eorzes/PSLink_v1/PCB-3D.png

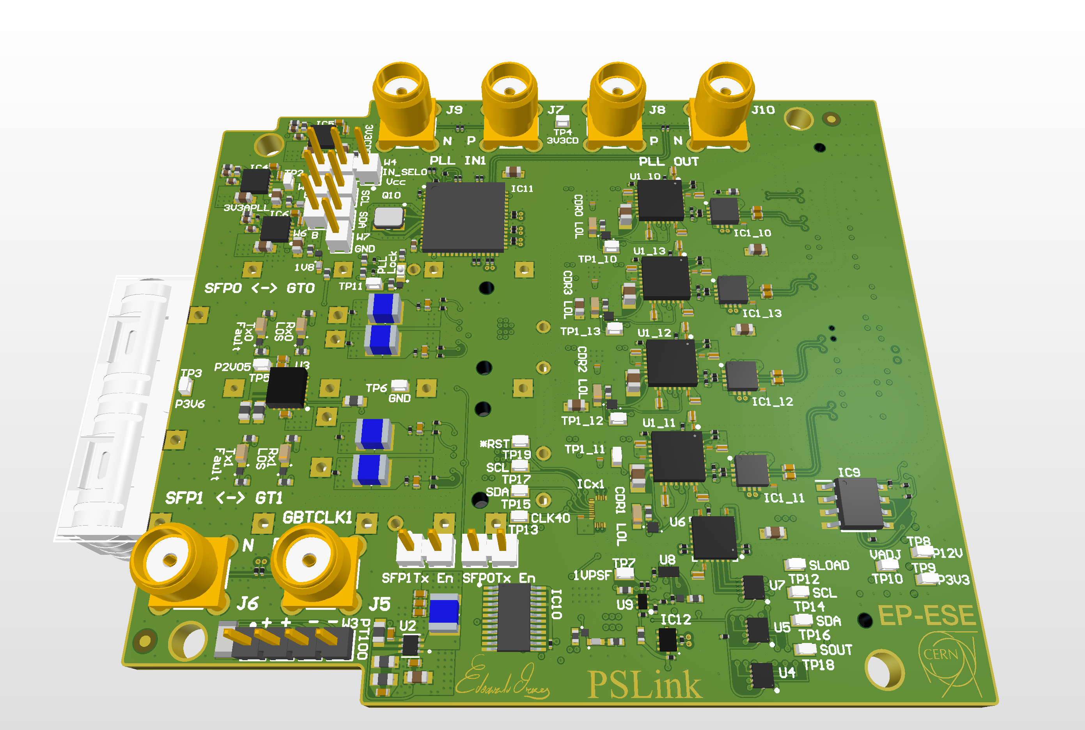
PCB-3D.png
