eorzes/PSLink_v1/PCB-3D-bot.png

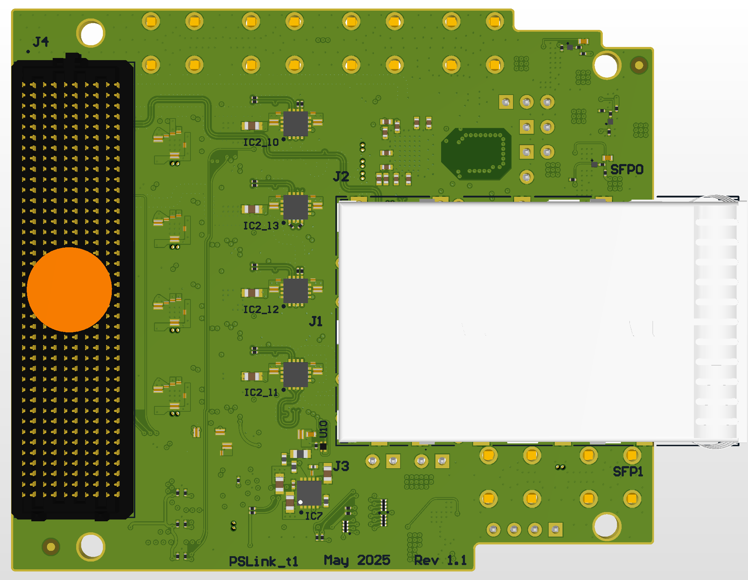
PCB-3D-bot.png
