eorzes/PSLink_v1/PCB-3D-top.png

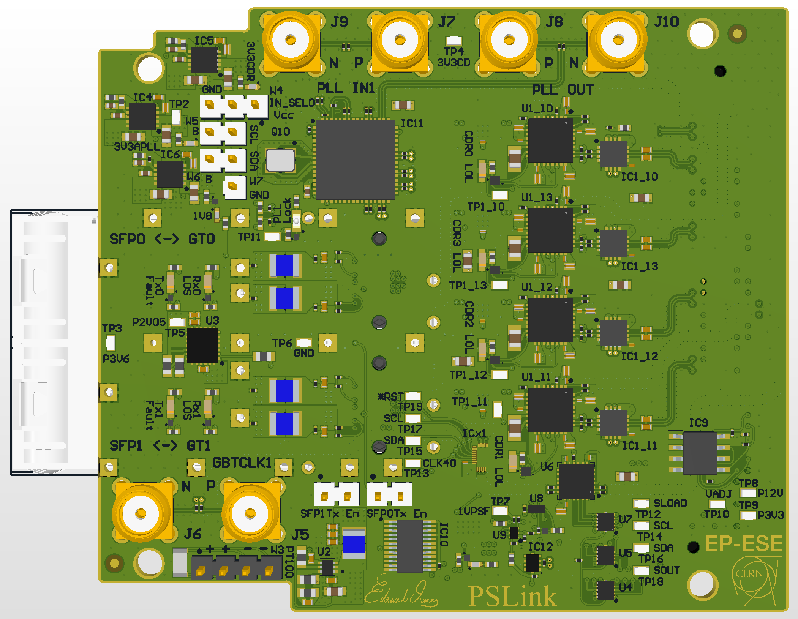
PCB-3D-top.png
