eorzes/PSLink_v1/SI_simulations/CML_Driver/AC_coupling_no50pullup.PNG

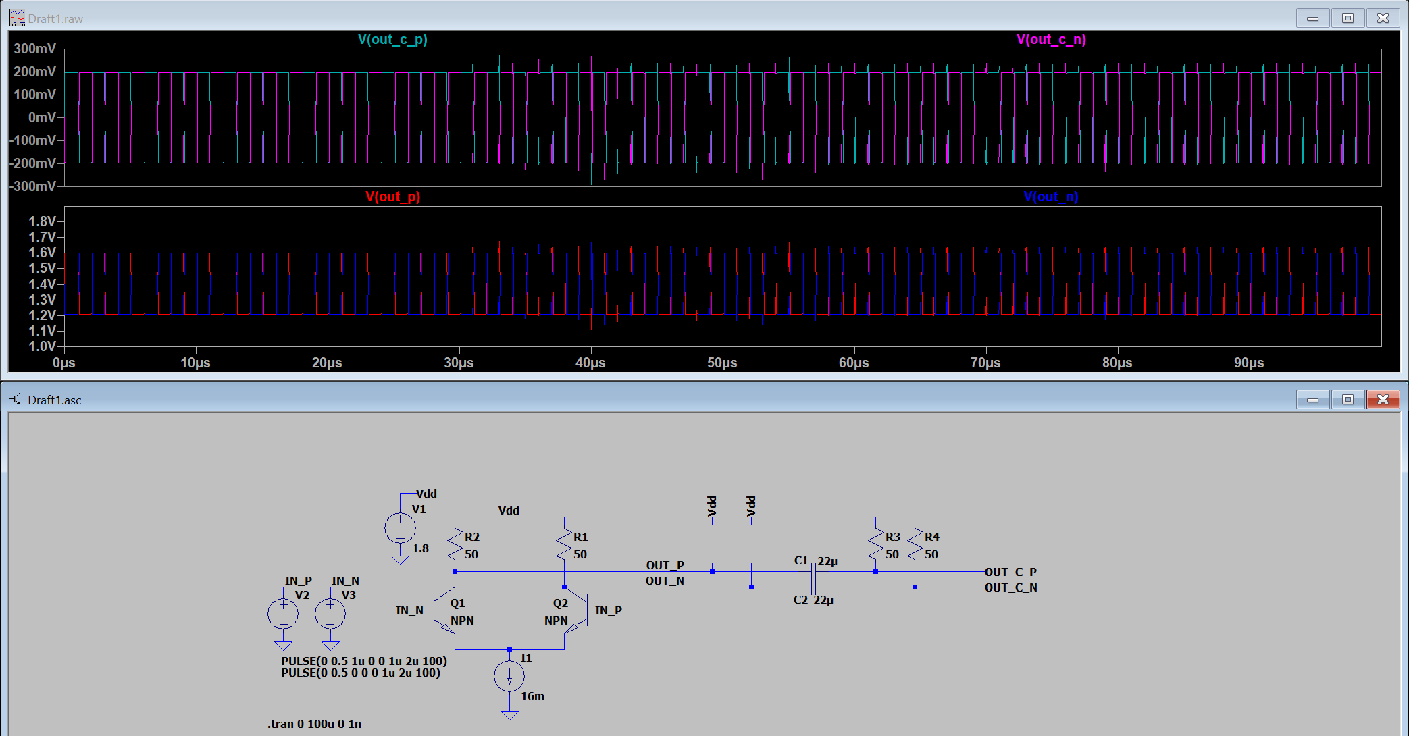
SI_simulations/CML_Driver/AC_coupling_no50pullup.PNG
