eorzes/PSLink_v1/Signature.png

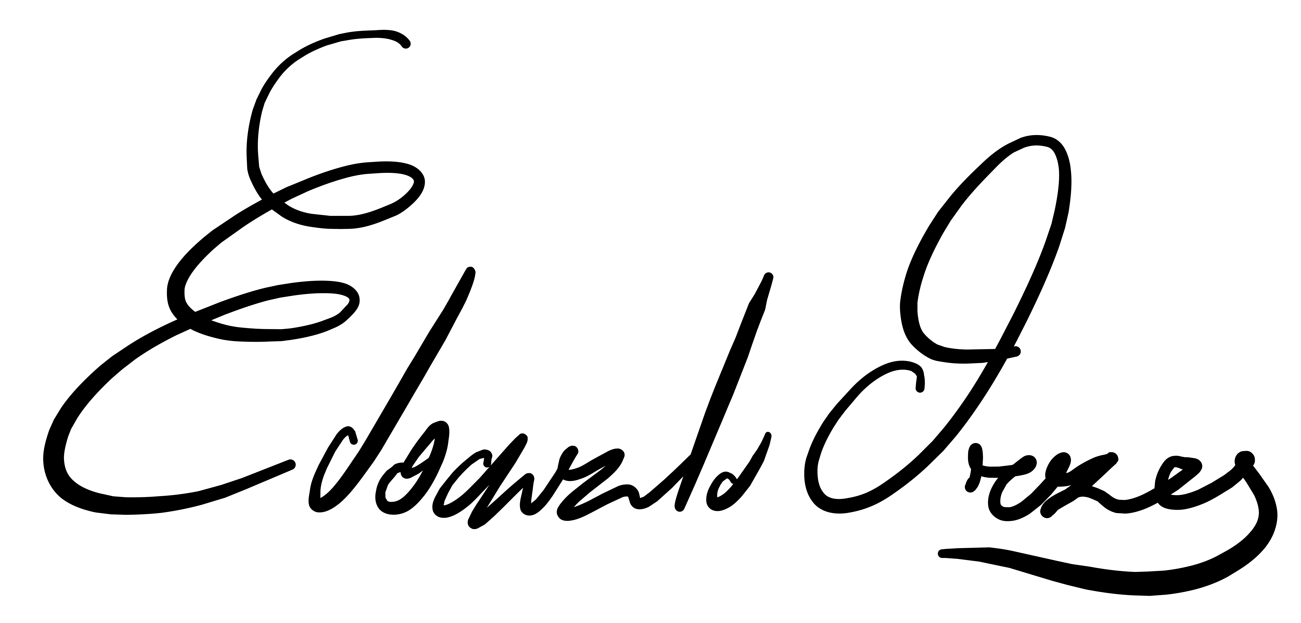
Signature.png
