eorzes/PSLink_v1/BOM_PSLink_v1.csv

Designator | Quantity | Manufacturer | Description | Comment | Footprint | Package | LibRef
C1_l0, C1_l1, C1_l2, C1_l3, C4_l0, C4_l1, C4_l2, C4_l3, C7_l0, C7_l1, C7_l2, C7_l3, C9_l0, C9_l1, C9_l2, C9_l3, C14_l0, C14_l1, C14_l2, C14_l3, C16_l0, C16_l1, C16_l2, C16_l3, C19_l0, C19_l1, C19_l2, C19_l3, C21_l0, C21_l1, C21_l2, C21_l3, C26_l0, C26_l1, C26_l2, C26_l3, C38, C51, C60, C132, C134, C136, C138, C143 | 44 |  | LLL153C70G474ME17 | 470nF | CAPC0510X04N |  | Capacitor - non polarized
C2_l0, C2_l1, C2_l2, C2_l3, C5_l0, C5_l1, C5_l2, C5_l3, C8_l0, C8_l1, C8_l2, C8_l3, C10_l0, C10_l1, C10_l2, C10_l3, C11_l0, C11_l1, C11_l2, C11_l3, C15_l0, C15_l1, C15_l2, C15_l3, C17_l0, C17_l1, C17_l2, C17_l3, C20_l0, C20_l1, C20_l2, C20_l3, C22_l0, C22_l1, C22_l2, C22_l3, C23_l0, C23_l1, C23_l2, C23_l3, C25_l0, C25_l1, C25_l2, C25_l3, C27_l0, C27_l1, C27_l2, C27_l3, C31_l0, C31_l1, C31_l2, C31_l3, C66, C133, C135, C137, C139, C144 | 58 |  | LLL03TR61E333KE01 | 33nF | LLL03TR61E333KE01 |  | Capacitor - non polarized
C3_l0, C3_l1, C3_l2, C3_l3, C6_l0, C6_l1, C6_l2, C6_l3, C34, C35, C43, C46, C47, C56, C57, C62, C65, C67, C129, C130 | 20 | GENERIC | C1608X5R1E106M080AC | 10uF | CAPC1608X87N |  | CC0603_10UF_6.3V_20%_X5R
C12_l0, C12_l1, C12_l2, C12_l3, C24_l0, C24_l1, C24_l2, C24_l3, C37, C44, C45, C50, C53, C54, C55, C59, C70, C73, C76, C79, C131 | 21 |  | GRM155R60J226ME11 | 22uF | MURATA_HI_DENSITY_0402_CAP |  | C0402-22uF-high-density
C13_l0, C13_l1, C13_l2, C13_l3, C18_l0, C18_l1, C18_l2, C18_l3, C28_l0, C28_l1, C28_l2, C28_l3, C29_l0, C29_l1, C29_l2, C29_l3, C30_l0, C30_l1, C30_l2, C30_l3, C33, C69, C71, C72, C74, C75, C77, C78, C80, C81, C82, C83, C84, C85, C86, C87, C88, C89, C90, C91, C92, C93, C94, C95, C96, C97, C98, C99, C100, C101, C102, C103, C104, C105, C106, C107, C108, C109, C110, C111, C112, C113, C114, C119, C120, C140, C141, C142, C145, C146, C147, C148, C149, C150, C151 | 75 |  | GRM033R61C104KE14 | 100nF | MURATA_HI_DENSITY_0201 |  | C0201-100nF-high-density
C32_l0, C32_l1, C32_l2, C32_l3 | 4 | MURATA | GCM21BR71H474KA55L | 470nF | CAPC2013X140N |  | CC0805_470NF_50V_10%_X7R_MURATA_GCM21BR71H474KA55L
C36, C39, C49, C52, C58, C61, C115, C116, C117, C118, C121, C122, C123, C124, C125, C126, C127, C128 | 18 | GENERIC | GRM153B30J105ME15 | 1uF | CAPC1005X55N |  | CC0402_1UF_16V_10%_X5R
C40, C41, C42 | 3 |  | GRM155R71E104KE14 | 100nF | MURATA_HI_DENSITY_0402_CAP |  | C0402-22uF-high-density
C48, C63, C68 | 3 |  | C0402C220J4GACTU | 22pF | MURATA_HI_DENSITY_0402_CAP |  | C0402-22uF-high-density
C64 | 1 | TDK | GRM033C80J224KE90D | 220nF | CAPC0603X33N |  | CC0201_220NF_6.3V_10%_X7S_TDK_C0603X7S0J224K030
D1, D2, D3, D4 | 4 |  | Led Green 0402 2mA 2.65V 40mcd 102mW | APHHS1005LZGCK-V | LED_APHHS1005LZGCK-V | 0402 Kingbright Corporation | APHHS1005LZGCK-V
D5 | 1 |  | LED | APTD1608LVBC_D | LEDC1608X110N |  | APTD1608LVBC_D
FTG1, FTG2, FTG3, FTG4 | 4 |  | Fiducial Target | Use only in PCB | FIDUCIAL_TOP_C100-200 |  | FIDUCIAL_TARGET_C100-200
IC1_l0, IC1_l1, IC1_l2, IC1_l3 | 4 |  | Integrated Circuit | NB7V52MMNG | QFN50P300X300X100-17N |  | NB7V52MMNG
IC2_l0, IC2_l1, IC2_l2, IC2_l3 | 4 |  | Integrated Circuit | NB7VQ14MMNHTBG | QFN50P300X300X100-17N |  | NB7VQ14MMNHTBG
IC3_l0, IC3_l1, IC3_l2, IC3_l3 | 4 |  | Integrated Circuit | 74AUP1G32GS,132 | 74LVC1G3157GS132 |  | 74AUP1G32GS,132
IC4, IC5, IC6 | 3 |  | Integrated Circuit | ADP7159ACPZ-04-R7 | SON50P300X300X85-11N-D |  | ADP7159ACPZ-04-R7
IC7 | 1 | LINEAR TECHNOLOGY | 20V, 500mA, Ultralow Noise, Ultrahigh PSRR Linear Regulator | LT3045EDD | SON50P300X300X80-11N-R175X248 |  | LT3045EDD#PBF
IC8 | 1 |  | 32207590 - PT100 - 1206 - 0.3degC - -50/130 | 32207590 | PT100 |  | PT100
IC9 | 1 |  | Integrated Circuit | M24C02-RMN6TP | SOIC127P600X175-8N |  | M24C02-RMN6TP
IC10 | 1 |  | Integrated Circuit | TCA9548ADGSR | SOP50P490X110-24N |  | TCA9548ADGSR
IC11 | 1 |  | Integrated Circuit | SI5345B-D-GM | QFN50P900X900X90-65N-D |  | SI5345B-D-GM
IC12 | 1 |  | Integrated Circuit | SN65LVDS4RSER | SN65LVDS4RSER |  | SN65LVDS4RSER
ICx1 | 1 |  |  | DCPS3 | DCPS3-Large |  | DCPS3
J1 | 1 |  | Connector | 2007263-1_NP | 20072631_NP |  | 2007263-1_NP
J2, J3 | 2 | TYCO ELECTRONICS | 20 Position SFP+ Connector (Small Form-factor Pluggable) | SFP+ | TYCO_1888247-1 |  | TYCO_1888247-1
J4 | 1 |  |  | SEAM-40-03.5-S-10-2-A-K-TR | SAMTEC_SEAM-40-03.5-S-10-2-A-K-TR | None | SEAM-40-03.5-S-10-2-A-K-TR
J5, J6, J7, J8, J9, J10 | 6 | SAMTEC |  | SMA | SAMTEC_SMA-J-P-H-ST-MT1 |  | SAMTEC_SMA-J-P-H-ST-MT1
L1, L2, L3, L4, L5 | 5 |  | Inductor | 4.7uH | DFE322520FD1R0MP2 |  | DFE322520FD-4R7M=P2
LED1_l0, LED1_l1, LED1_l2, LED1_l3, LED2, LED3, LED4, LED5 | 8 |  | Led Red 0603 2mA 1.8V 50mcd 84mW | APTD1608LSECKJ3-PF | LED_APTD1608LSECKJ3-PF_KNB |  | APTD1608LSECKJ3-PF
Q1, Q2, Q3, Q4, Q5, Q6, Q7, Q8, Q9, Q11, Q12 | 11 |  | MOSFET (N-Channel) | CSD15380F3 | CSD15380F3 |  | CSD15380F3
Q10 | 1 | KYOCERA | Crystal 4 pins 1=XTAL Control 2=GND3=XTAL 4=GND | 48MHz | XTAL_KYOCERA_CX3225SB |  | XTAL_48MHZ_KYOCERA_CX3225SB48000D0FPJC1
R1_l0, R1_l1, R1_l2, R1_l3, R2_l0, R2_l1, R2_l2, R2_l3, R5_l0, R5_l1, R5_l2, R5_l3, R8, R29, R37, R65, R66, R67, R75 | 19 |  | Resistor | 100O | MURATA_HI_DENSITY_0201 |  | R0201-100ohm-high-density
R3_l0, R3_l1, R3_l2, R3_l3, R4_l0, R4_l1, R4_l2, R4_l3, R23, R27, R43, R44, R45, R48, R51, R52, R53, R56, R57, R58, R59, R60, R61, R62, R63, R64, R68, R69, R76, R81, R82, R83, R84 | 33 |  | Resistor 10k | 10k | MURATA_HI_DENSITY_0201 |  | R0201-100ohm-high-density
R6_l0, R6_l1, R6_l2, R6_l3, R41, R42, R49, R50, R77 | 9 | GENERIC | Resistor - 1% | 1k5 | RESC1005X40N |  | R0402_1K5_1%_0.0625W_100PPM
R7, R10, R28, R32, R36, R40, R78, R79 | 8 |  | Resistor 1M | 1M | MURATA_HI_DENSITY_0201 |  | R0201-100ohm-high-density
R9, R14, R21, R31, R72 | 5 | GENERIC | Resistor - 1% | 750 | RESC1005X40N |  | R0402_750R_1%_0.0625W_100PPM
R11, R17 | 2 | GENERIC | Resistor - 1% | 47k | RESC1005X40N |  | R0402_47K_1%_0.0625W_100PPM
R12, R18 | 2 | GENERIC | Resistor - 1% | 27k | RESC1005X40N |  | R0402_27K_1%_0.0625W_100PPM
R13, R19, R22 | 3 | GENERIC | Resistor - 1% | 100k | RESC1608X55N |  | R0603_30K_1%_0.1W_100PPM
R15 | 1 | GENERIC | Resistor - 1% | 150k | RESC1608X55N |  | R0603_150K_1%_0.1W_100PPM
R16 | 1 | GENERIC | Resistor - 1% | 30k | RESC1608X55N |  | R0603_30K_1%_0.1W_100PPM
R20, R39 | 2 | GENERIC | Resistor - 1% | 243k | RESC1608X55N |  | R0603_30K_1%_0.1W_100PPM
R24, R33, R38, R46, R47, R54, R55, R73, R74, R80 | 10 | GENERIC | Resistor - 1% | 200k | RESC1005X40N |  | R0402_200K_1%_0.0625W_100PPM
R25 | 1 | GENERIC | Resistor - 1% | 5k1 | RESC1005X40N |  | R0402_5K1_1%_0.0625W_100PPM
R26 | 1 | GENERIC | Resistor - 1% | 20k | RESC1005X40N |  | R0402_20K_1%_0.0625W_100PPM
R30 | 1 | GENERIC | Resistor - 1% | 300 | RESC1005X40N |  | R0402_300R_1%_0.0625W_100PPM
R34 | 1 | GENERIC | Resistor - 1% | 750k | RESC1005X40N |  | R0402_750K_1%_0.0625W_100PPM
R35 | 1 | GENERIC | Resistor | 10k | RESC0603X28N |  | R0201_0R_JUMPER
R70, R71 | 2 | GENERIC | Resistor - 1% | 22 | RESC1005X40N |  | R0402_22R_1%_0.0625W_100PPM
RN1, RN2, RN3 | 3 |  | Resistor Network (8-Pin) 10k | EXB-U18103JX | EXBU18 |  | EXB-U18103JX
TP1_l0, TP1_l1, TP1_l2, TP1_l3, TP2, TP3, TP4, TP5, TP6, TP7, TP8, TP9, TP10, TP11, TP12, TP13, TP14, TP15, TP16, TP17, TP18, TP19 | 22 |  |  | RCU-0C | TP+195X110 | None | RCU-0C
U1_l0, U1_l1, U1_l2, U1_l3 | 4 |  | CDR | ADN2817ACPZ-RL7 | CP_32_11_ADI |  | ADN2817ACPZ-RL7
U2 | 1 |  | No Description Available | TPS563203DRLR | SOT_07SDRLR_TEX |  | TPS563203DRLR
U3 | 1 |  | No Description Available | TPSM82866AA0SRDJR | RDJ0023A-MFG |  | XPSM82866AA0SRDJR
U4, U5, U7 | 3 |  | No Description Available | TXB0104RUTR | RUT12_TEX |  | TXB0104RUTR
U6 | 1 |  | Coarse Phase Shifter (5ps/5ns) | SY89297UMG-TR | QFN-24_MCH-L |  | SY89297UMG-TR
U8 | 1 |  | No Description Available | SN74AUC2G241YZPR | YZP8 |  | SN74AUC2G241YZPR
U9 | 1 |  | No Description Available | TCA39306DTMR | DTM0008A-MFG |  | TCA39306DTMR
U10 | 1 |  | No Description Available | SN74AUP1G125DPWR | X2SON_TEX |  | SN74AUP1G125DPWR
W1, W2, W5, W6 | 4 | SAMTEC | 2 Mini Wire-Wrap Contact Strip Header | Header 2 | SAMTEC_HTSW-102-23-L-S |  | SAMTEC_HTSW-102-23-L-S
W3 | 1 | SAMTEC | 4 Mini Wire-Wrap Contact Strip Header | Header 4 | SAMTEC_HTSW-104-23-L-S |  | SAMTEC_HTSW-104-23-L-S
W4 | 1 | SAMTEC | 3 Mini Wire-Wrap Contact Strip Header | Header 3 | SAMTEC_HTSW-103-23-L-S |  | SAMTEC_HTSW-103-23-L-S
W7 | 1 | SAMTEC | Single Mini Wire-Wrap Contact | Header 1 | SAMTEC_HTSW-101-23-L-S |  | SAMTEC_HTSW-101-23-L-S
