eorzes/PSLink_v1/PSLink_v1.pdf

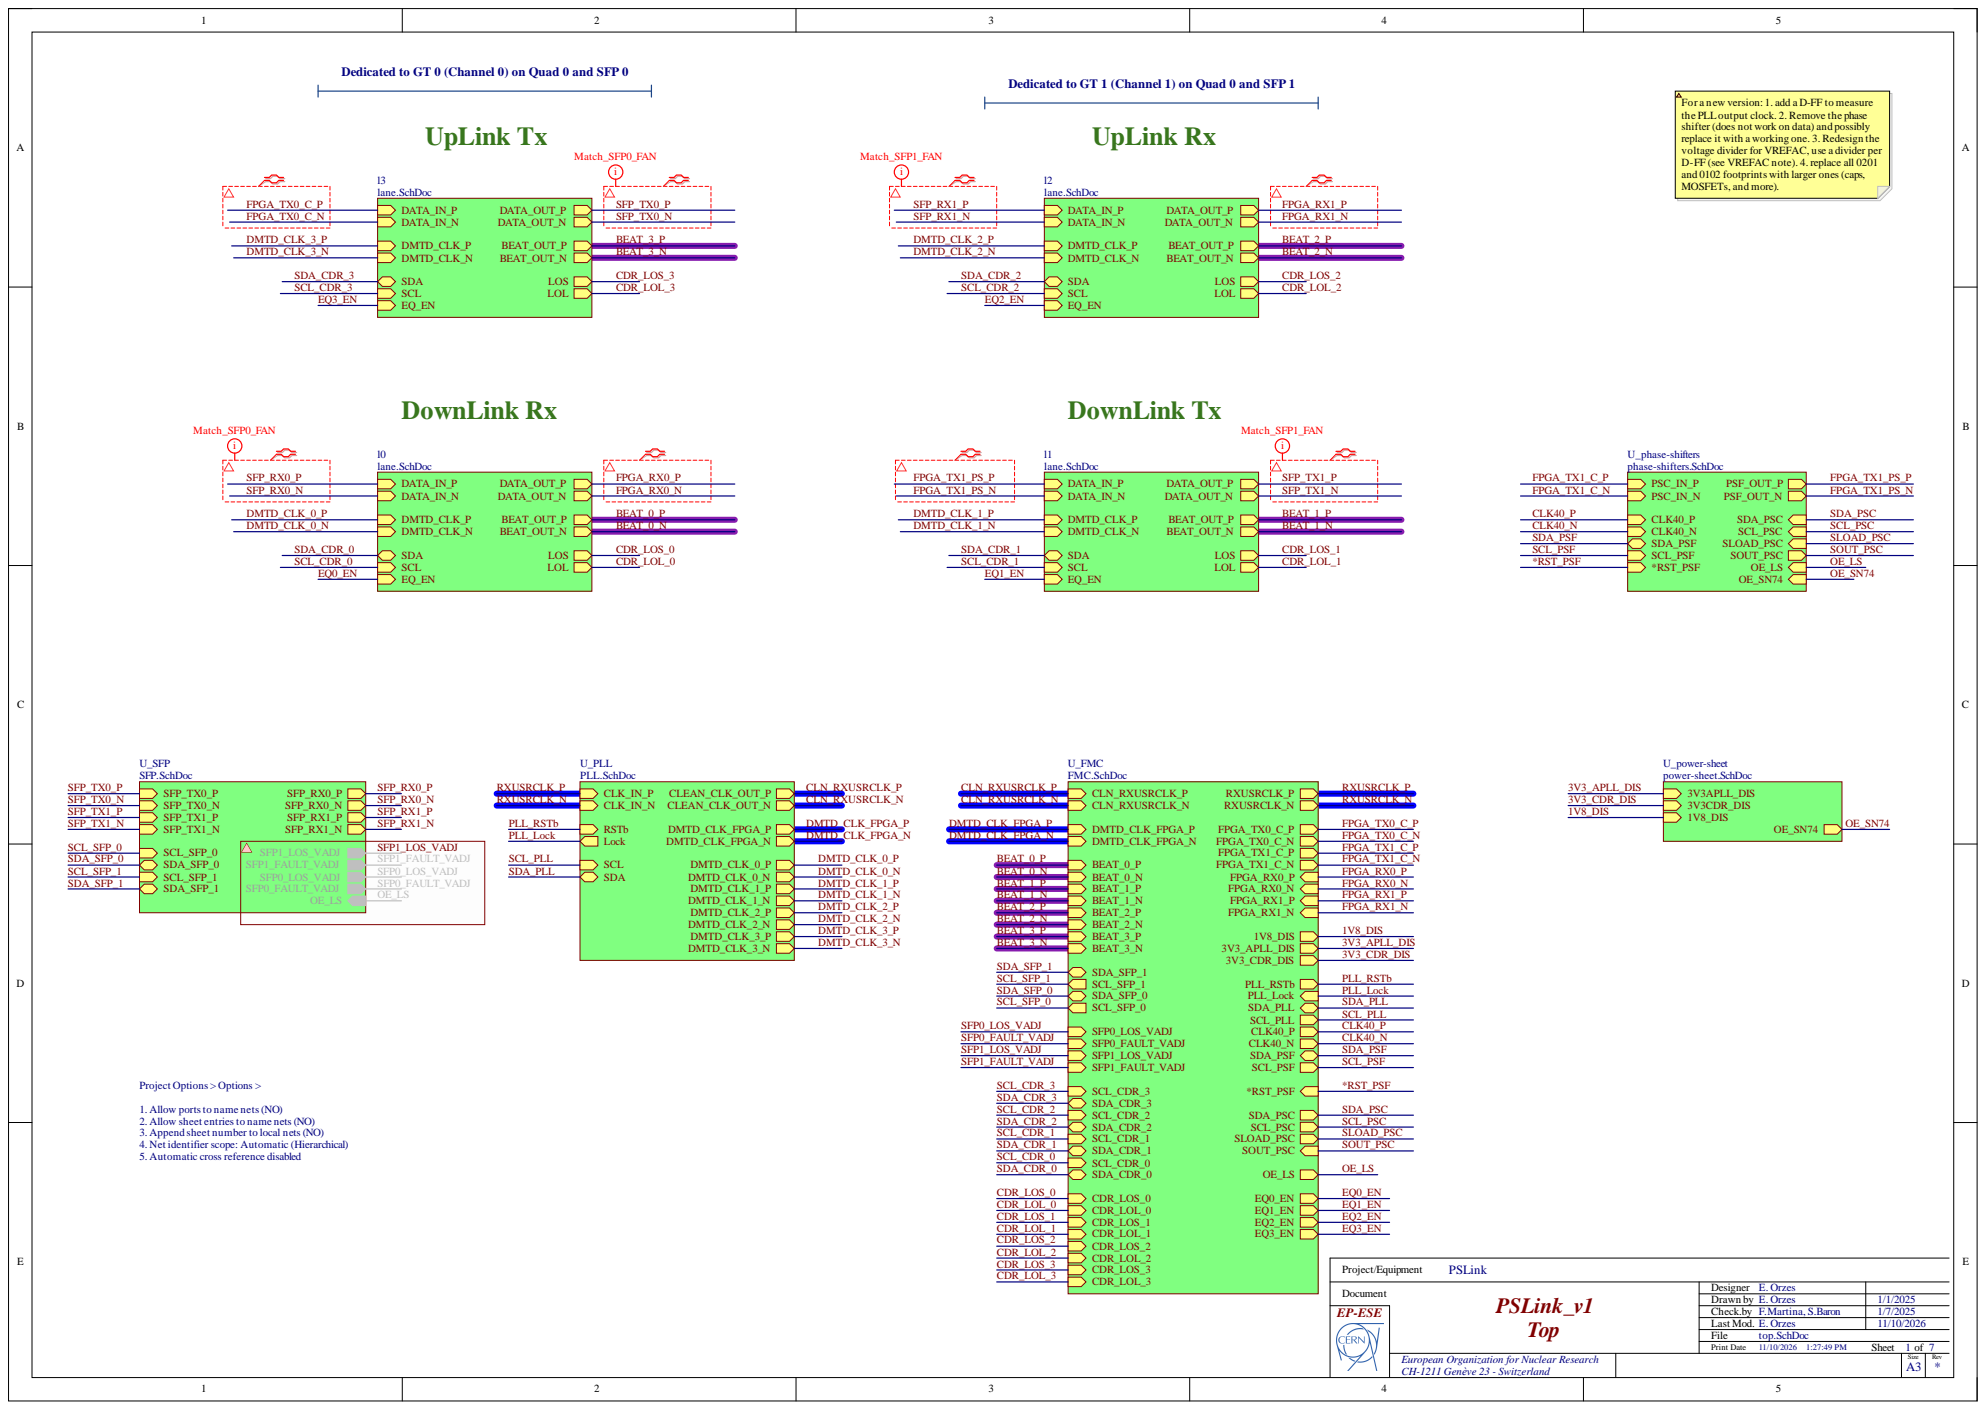
[picture p7: page 1]

For a new version: 1. add a D-FF to measure
the PLLoutput clock. 2. Remove the phase
shifter (does not work on data) and possibly
replace it with a working one. 3. Redesign the
voltage divider for VREFAC, use a divider per
D-FF (see VREFAC note). 4. replace all 0201
and 0102 footprints with larger ones (caps,
MOSFETs, and more).

1. Allow ports to name nets (NO)
2. Allow sheet entries to name nets (NO)
3. Append sheet number to local nets (NO)
4. Net identifier scope: Automatic (Hierarchical)
5. Automatic cross reference disabled

Designer E. Orzes
Drawn by E. Orzes
Check.by F.Martina, S.Baron

European Organization for Nuclear Research
CH-1211 Genève 23 - Switzerland

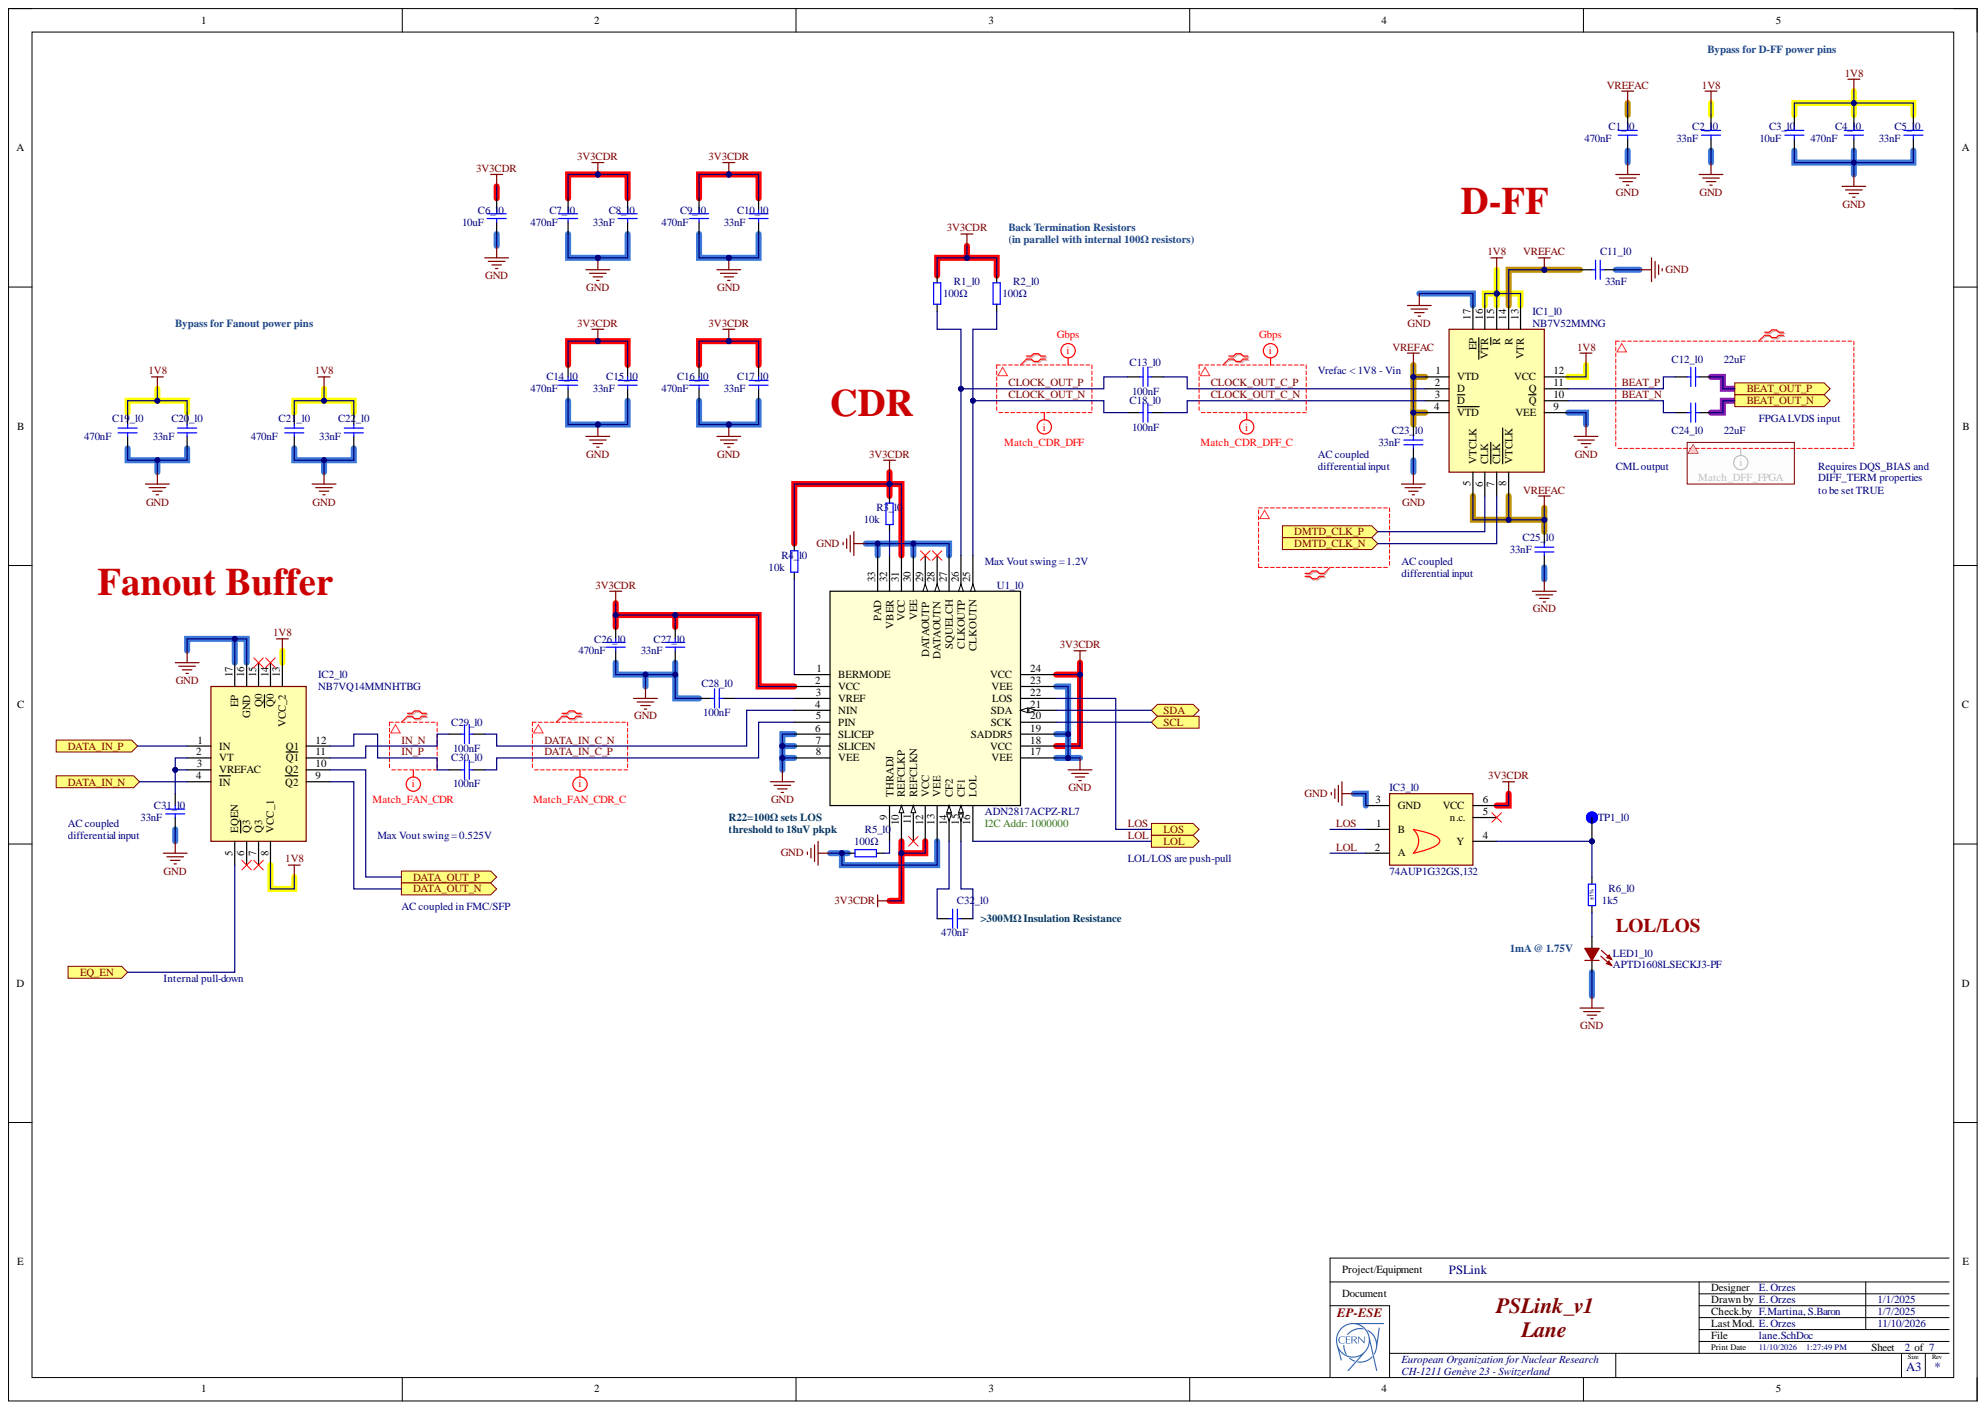
[picture p8: page 2]

Bypass for D-FF power pins

Back Termination Resistors
(in parallel with internal 100Ω resistors)

Bypass for Fanout power pins

Requires DQS_BIAS and
DIFF_TERM properties
to be set TRUE

CLKOUTN 25 CLKOUTP 26 SQUELCH 27 DATAOUTN 28 DATAOUTP 29 VEE 30 VCC 31 VBER 32 PAD 33

SLICEP 6 | | LOS
SLICEN 7

LOL/LOS are push-pull

Designer E. Orzes
Drawn by E. Orzes
Check.by F.Martina, S.Baron

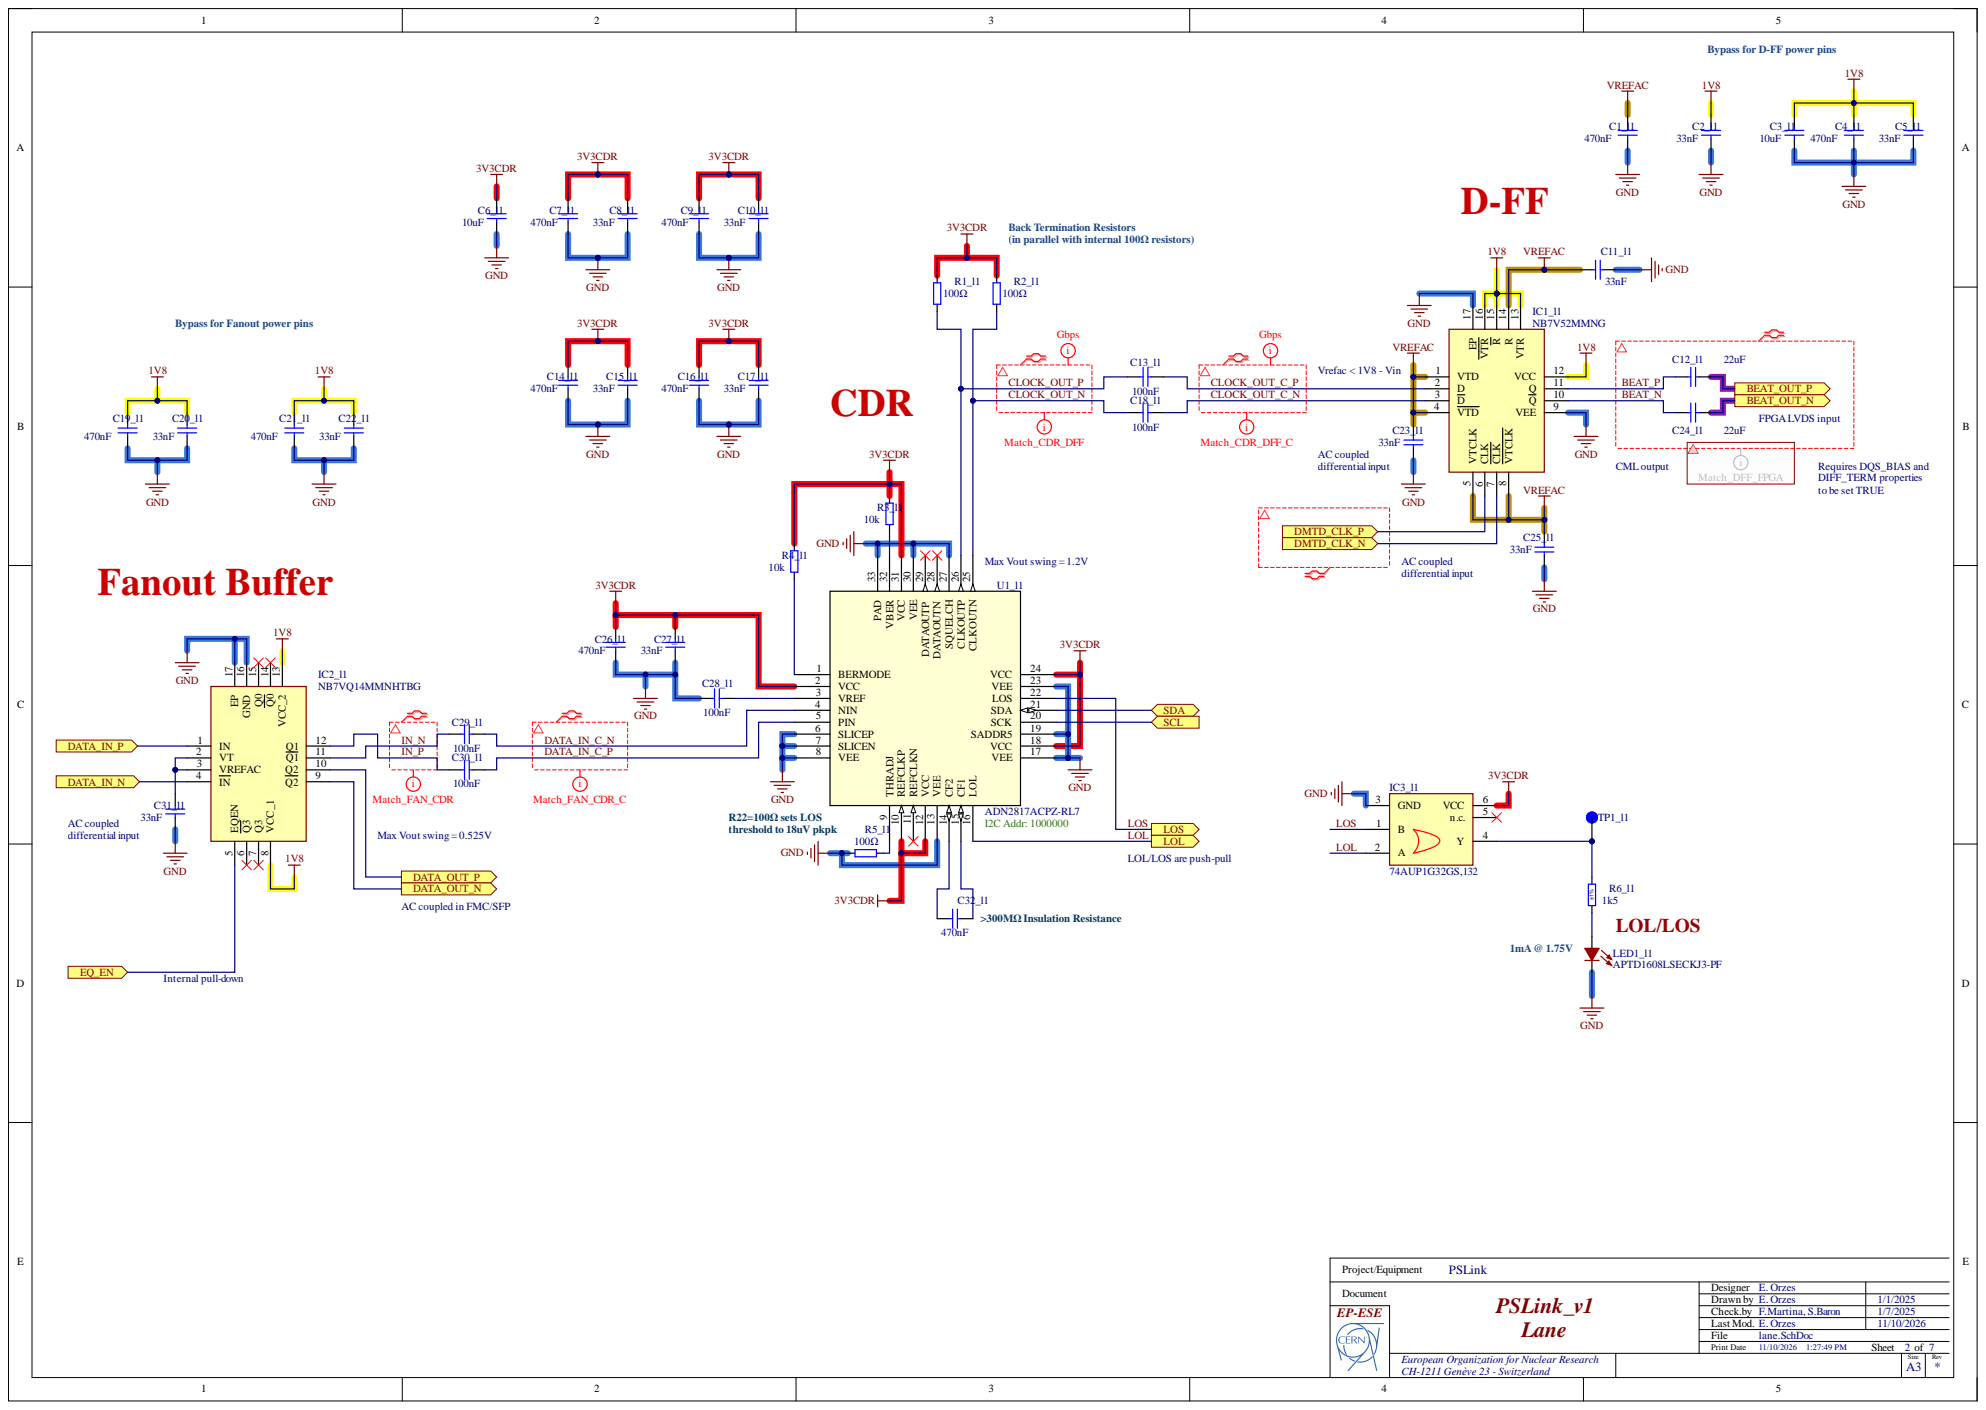
[picture p9: page 3]

Back Termination Resistors
(in parallel with internal 100Ω resistors)

Bypass for Fanout power pins

Requires DQS_BIAS and
DIFF_TERM properties
to be set TRUE

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

SLICEP 6 | | LOS
SLICEN 7

LOL/LOS are push-pull

Designer E. Orzes
Drawn by E. Orzes
Check.by F.Martina, S.Baron

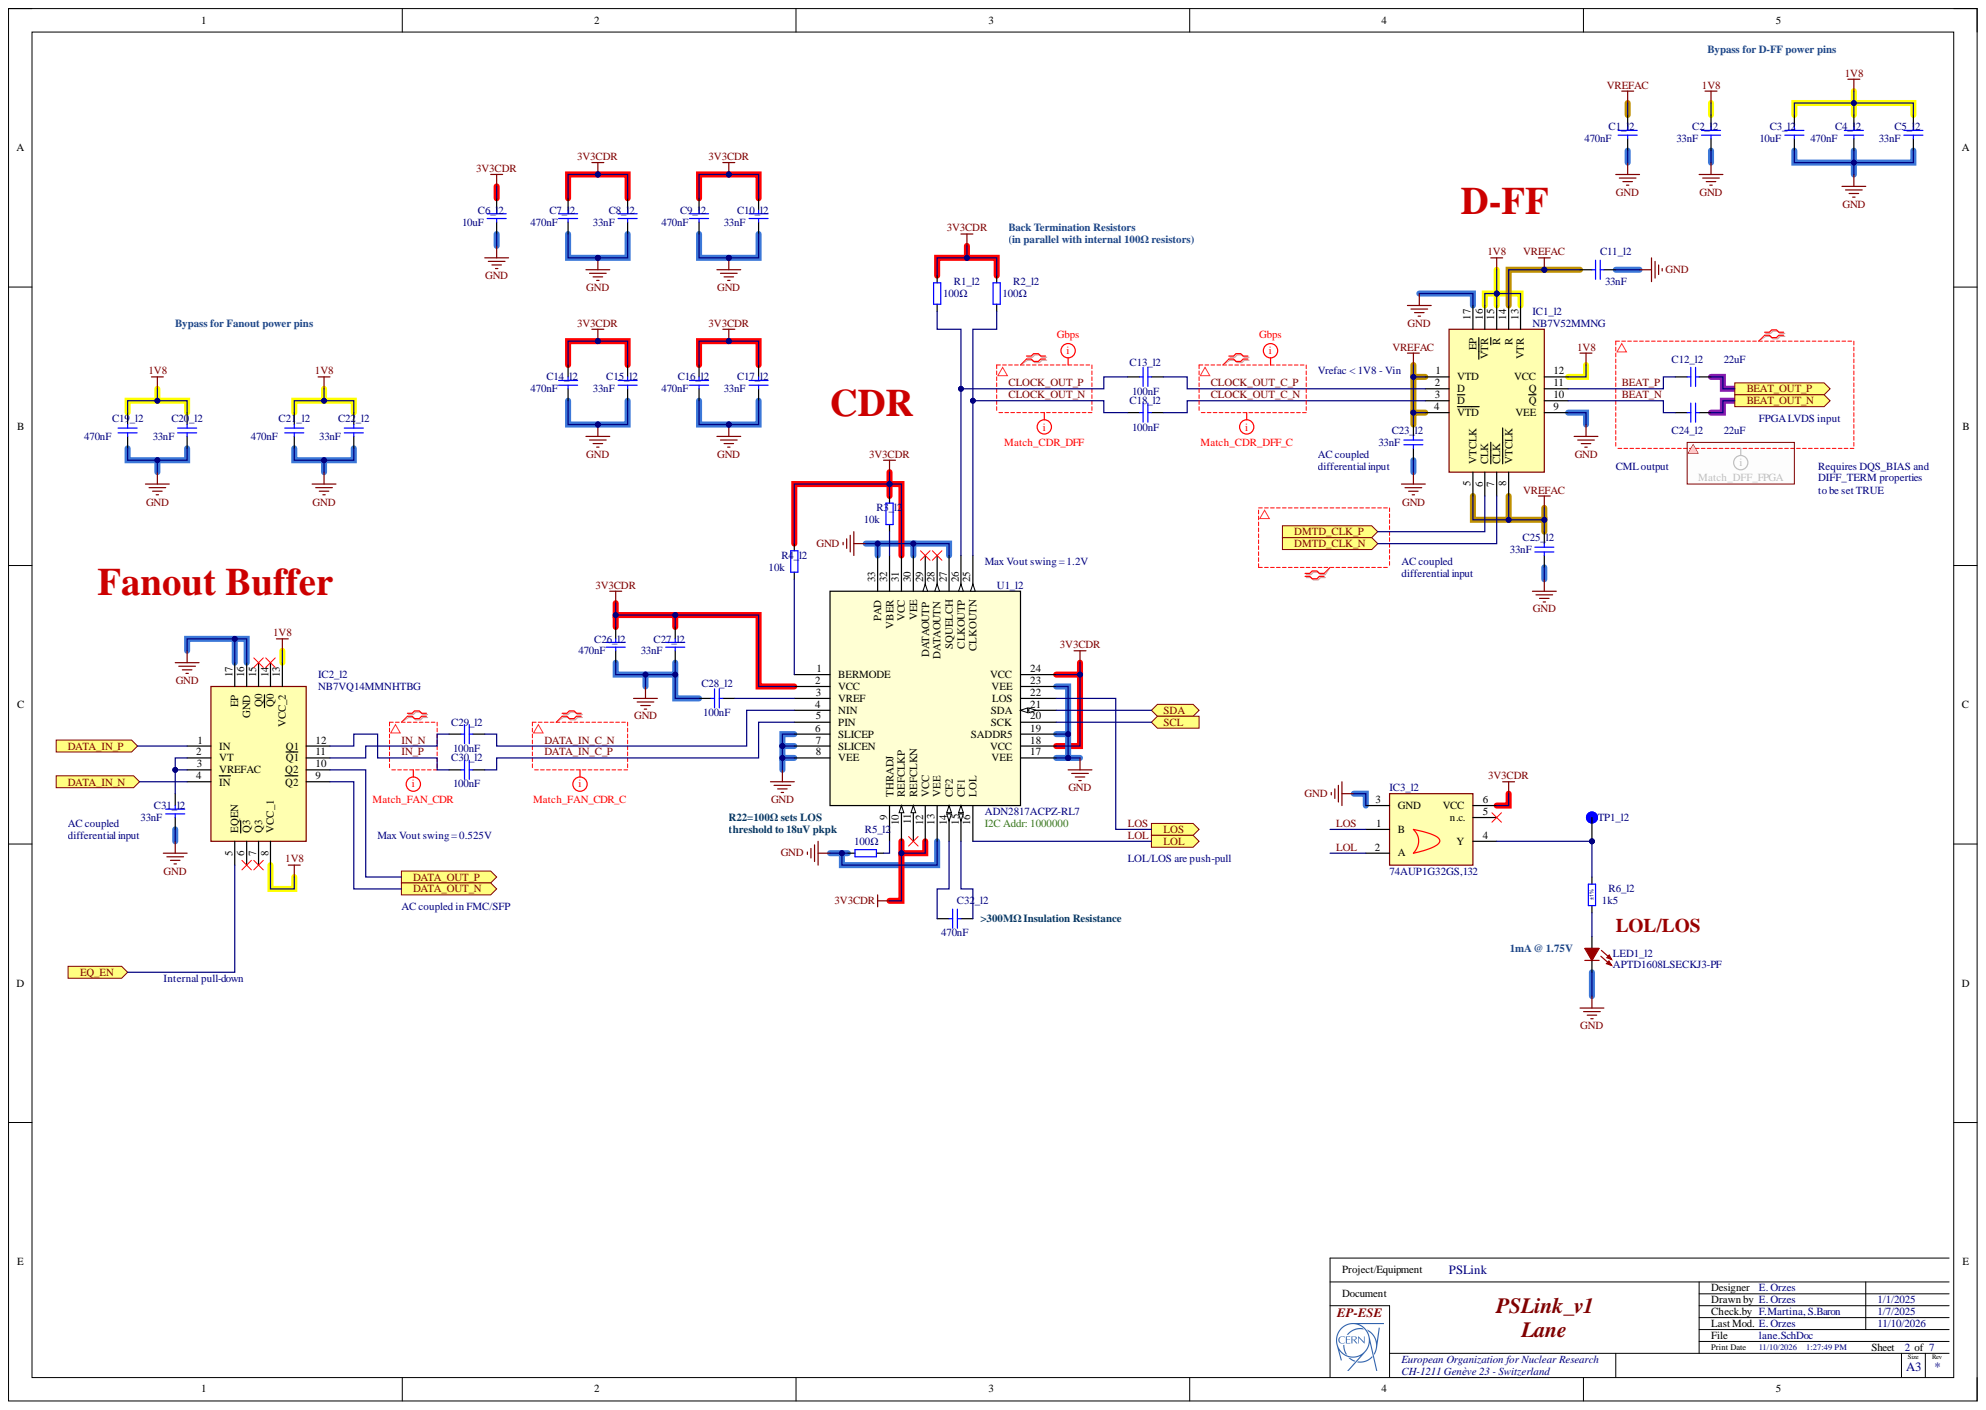
[picture p10: page 4]

Back Termination Resistors
(in parallel with internal 100Ω resistors)

Bypass for Fanout power pins

Requires DQS_BIAS and
DIFF_TERM properties
to be set TRUE

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

SLICEP 6 | | LOS
SLICEN 7

LOL/LOS are push-pull

Designer E. Orzes
Drawn by E. Orzes
Check.by F.Martina, S.Baron

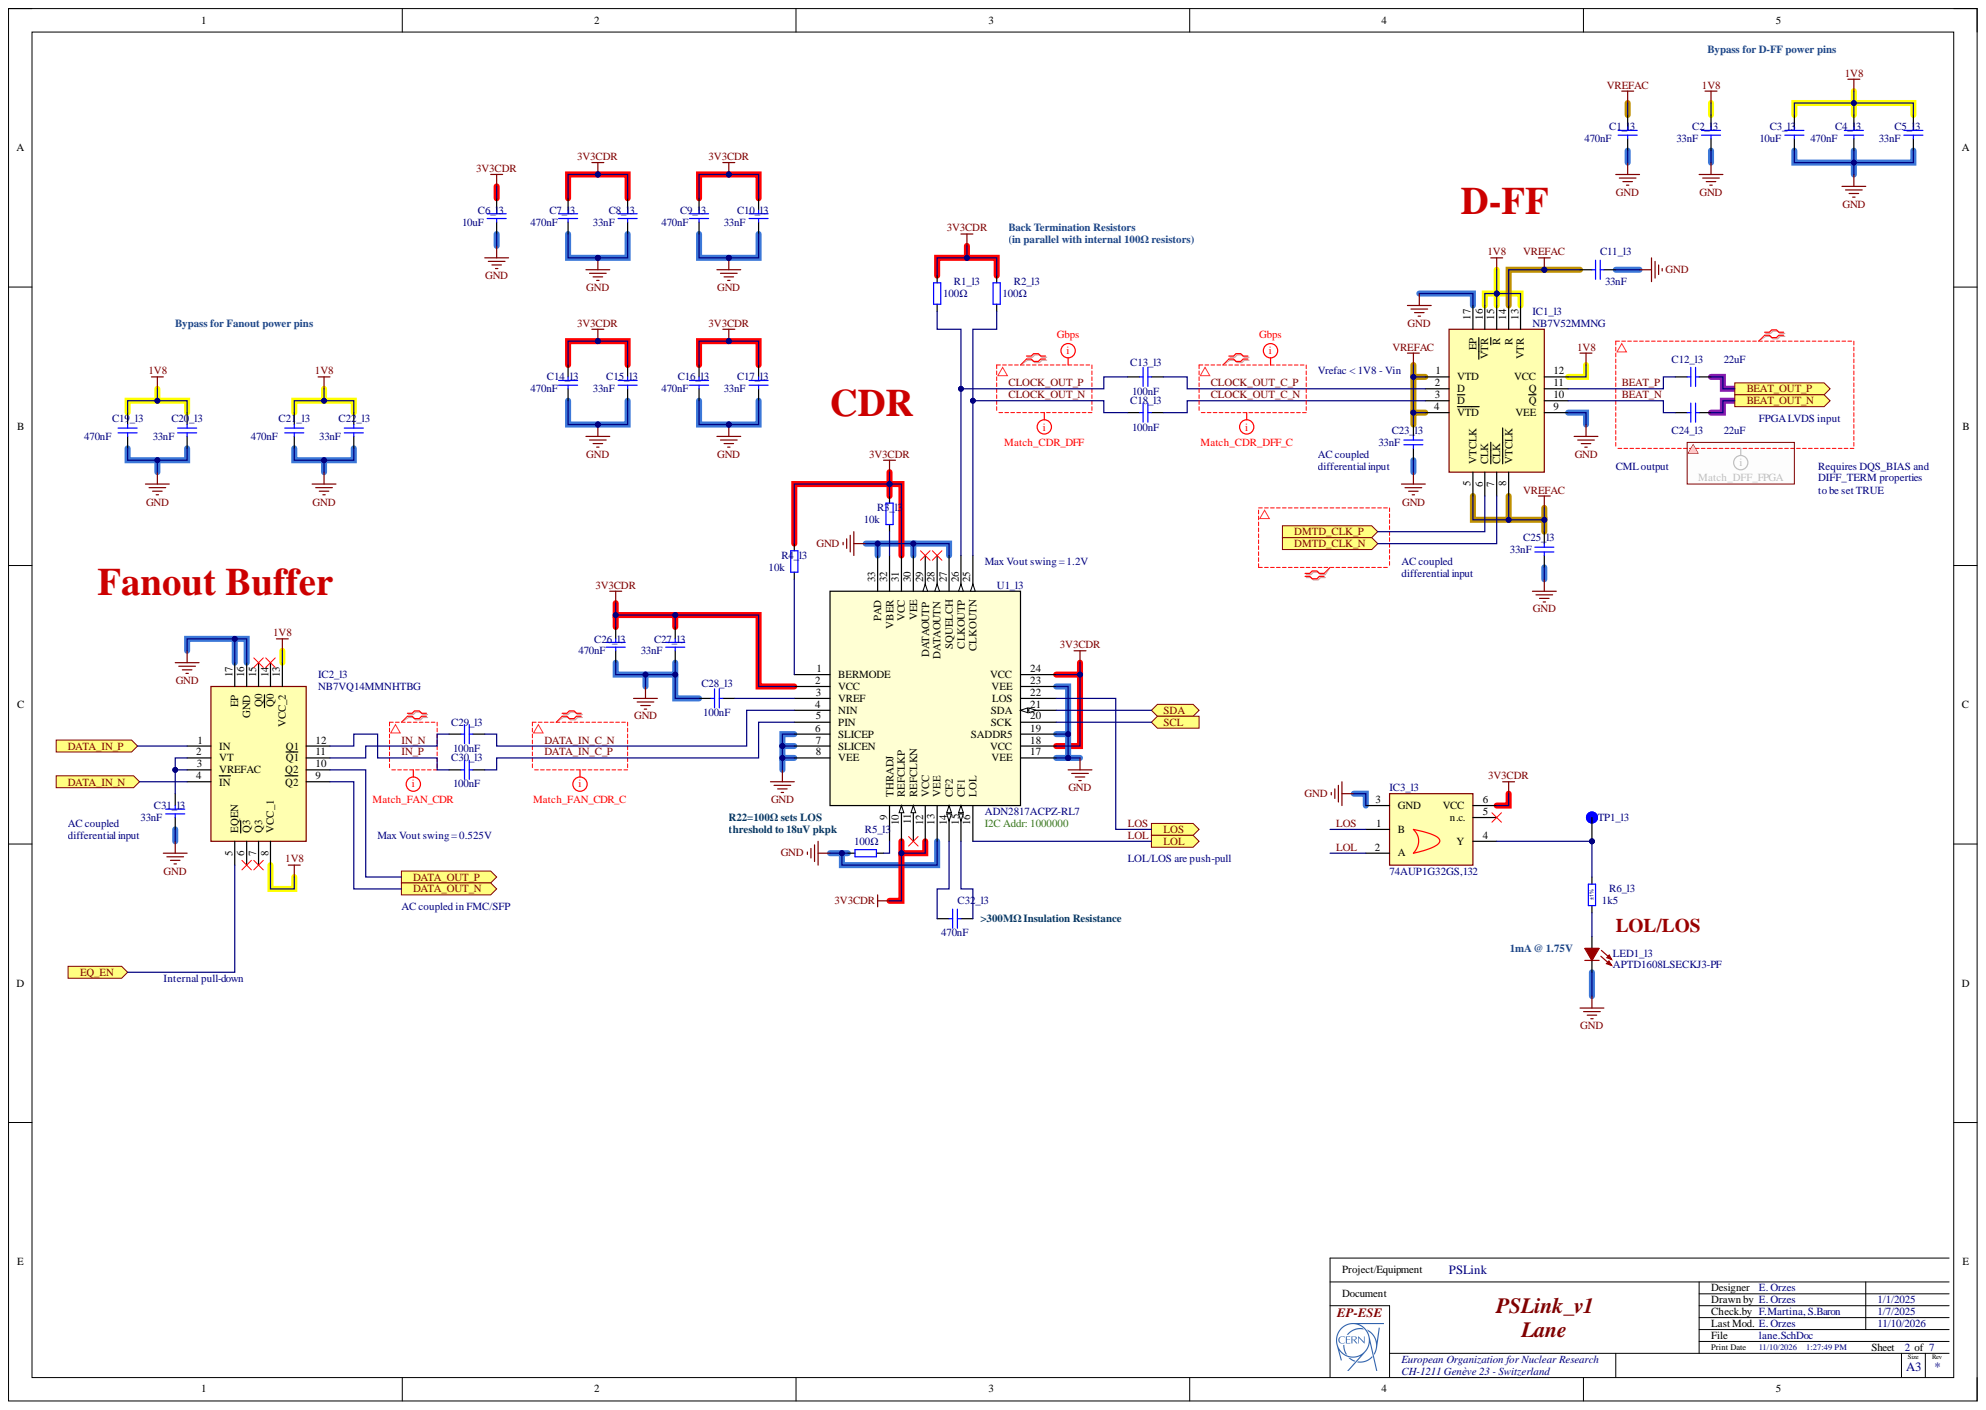
[picture p11: page 5]

Back Termination Resistors
(in parallel with internal 100Ω resistors)

Bypass for Fanout power pins

Requires DQS_BIAS and
DIFF_TERM properties
to be set TRUE

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

SLICEP 6 | | LOS
SLICEN 7

LOL/LOS are push-pull

Designer E. Orzes
Drawn by E. Orzes
Check.by F.Martina, S.Baron

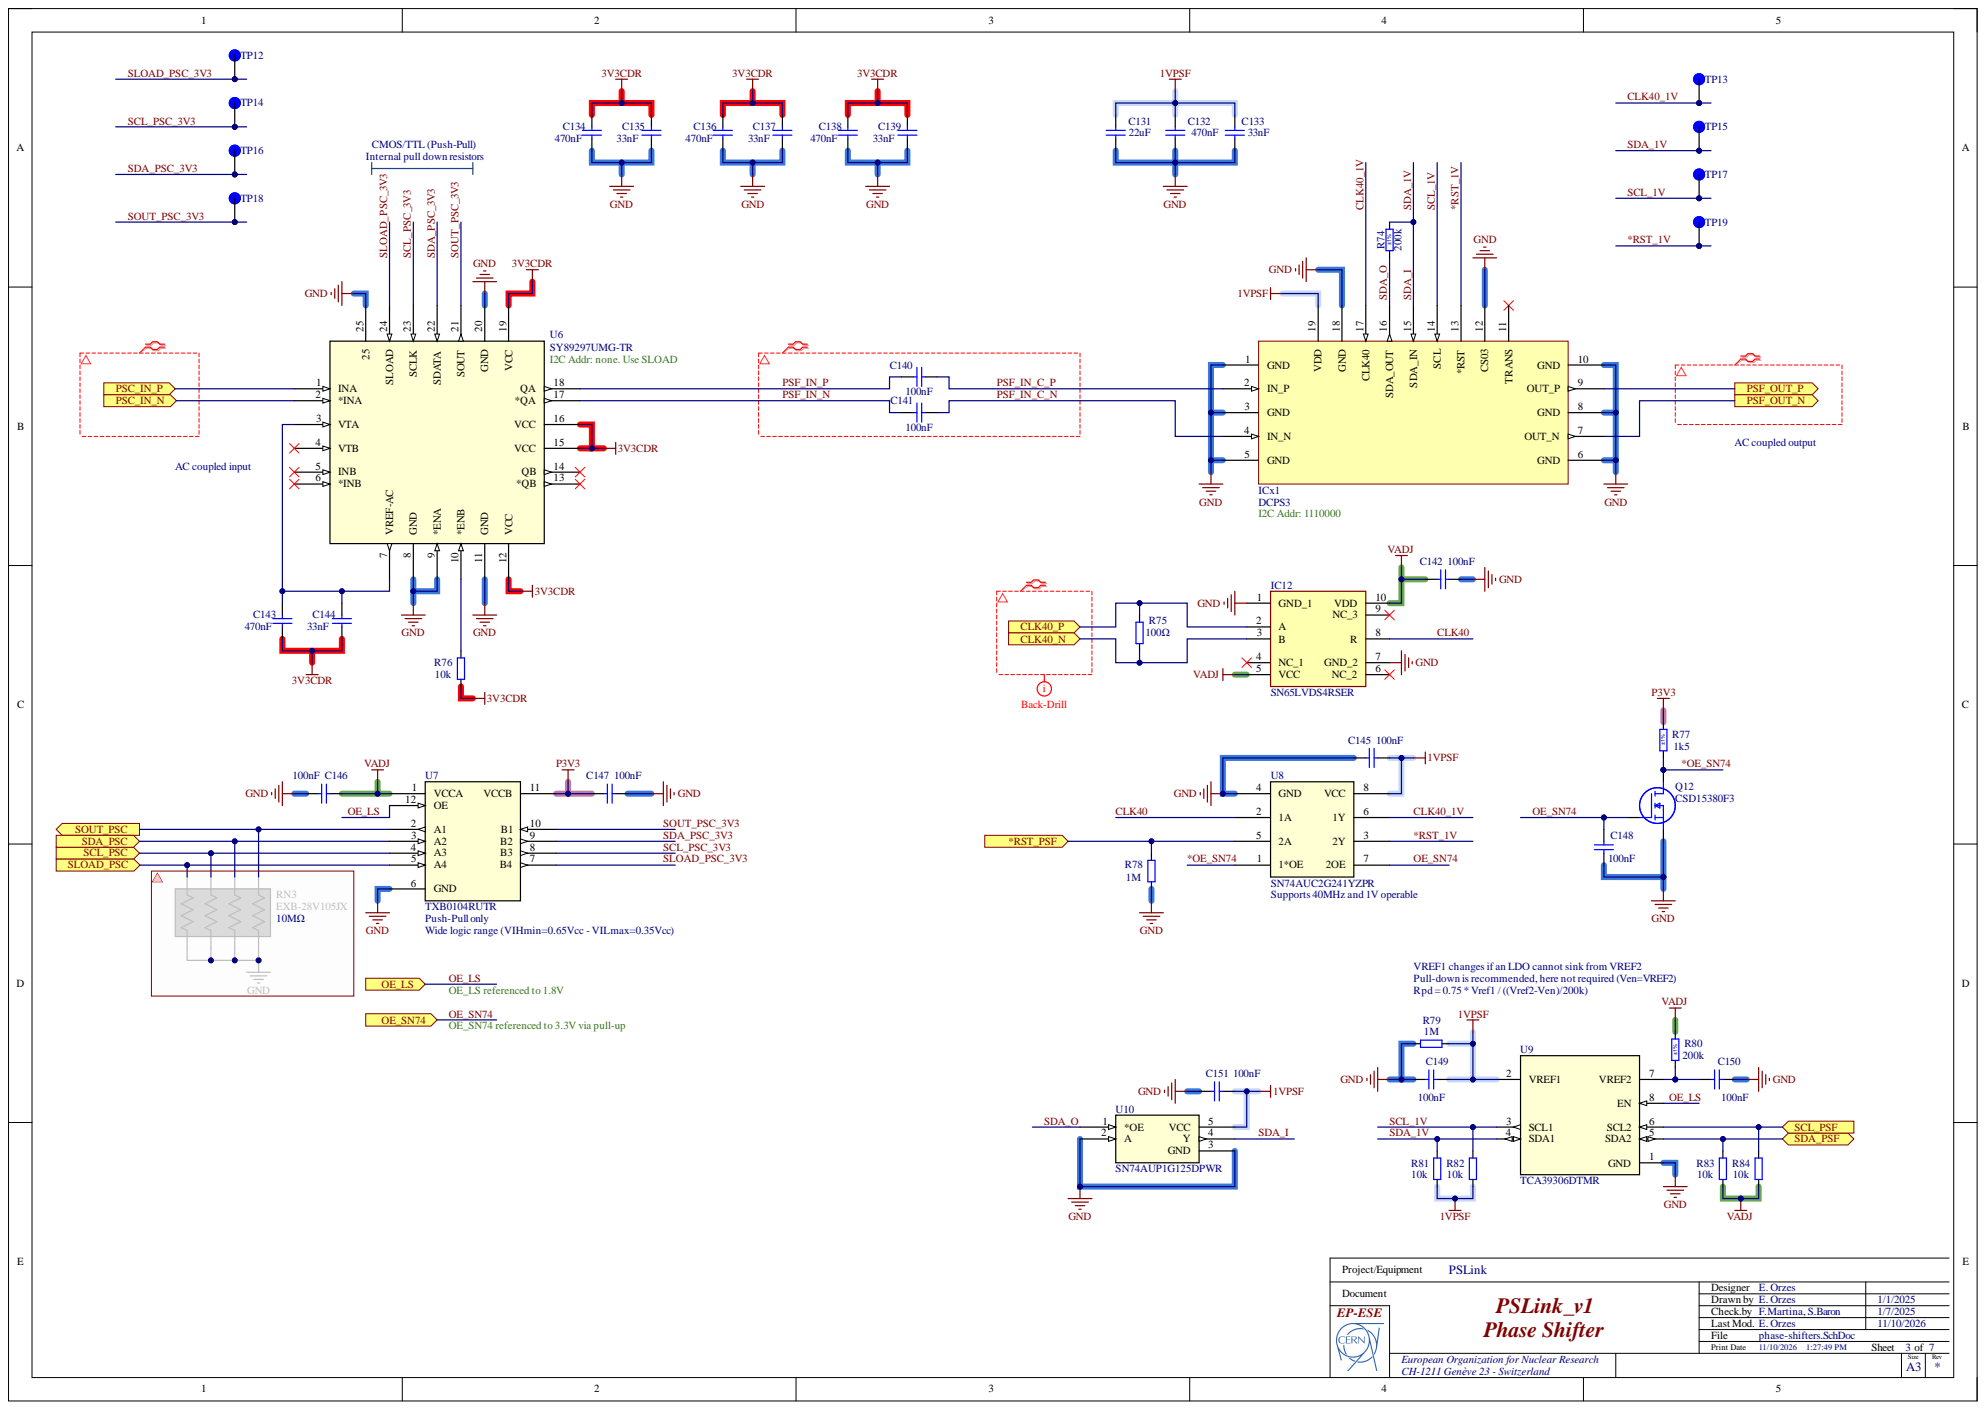
[picture p12: page 6]

CMOS/TTL (Push-Pull)
Internal pull down resistors

TXB0104RUTR
Push-Pull only
Wide logic range (VIHmin=0.65Vcc - VILmax=0.35Vcc)

VREF1 changes if an LDO cannotsink from VREF2
Pull-down is recommended, here not required (Ven=VREF2)
Rpd = 0.75 * Vref1 / ((Vref2-Ven)/200k)

OE_SN74 referenced to 3.3V via pull-up

Designer E. Orzes
Drawn by E. Orzes
Check.by F.Martina, S.Baron

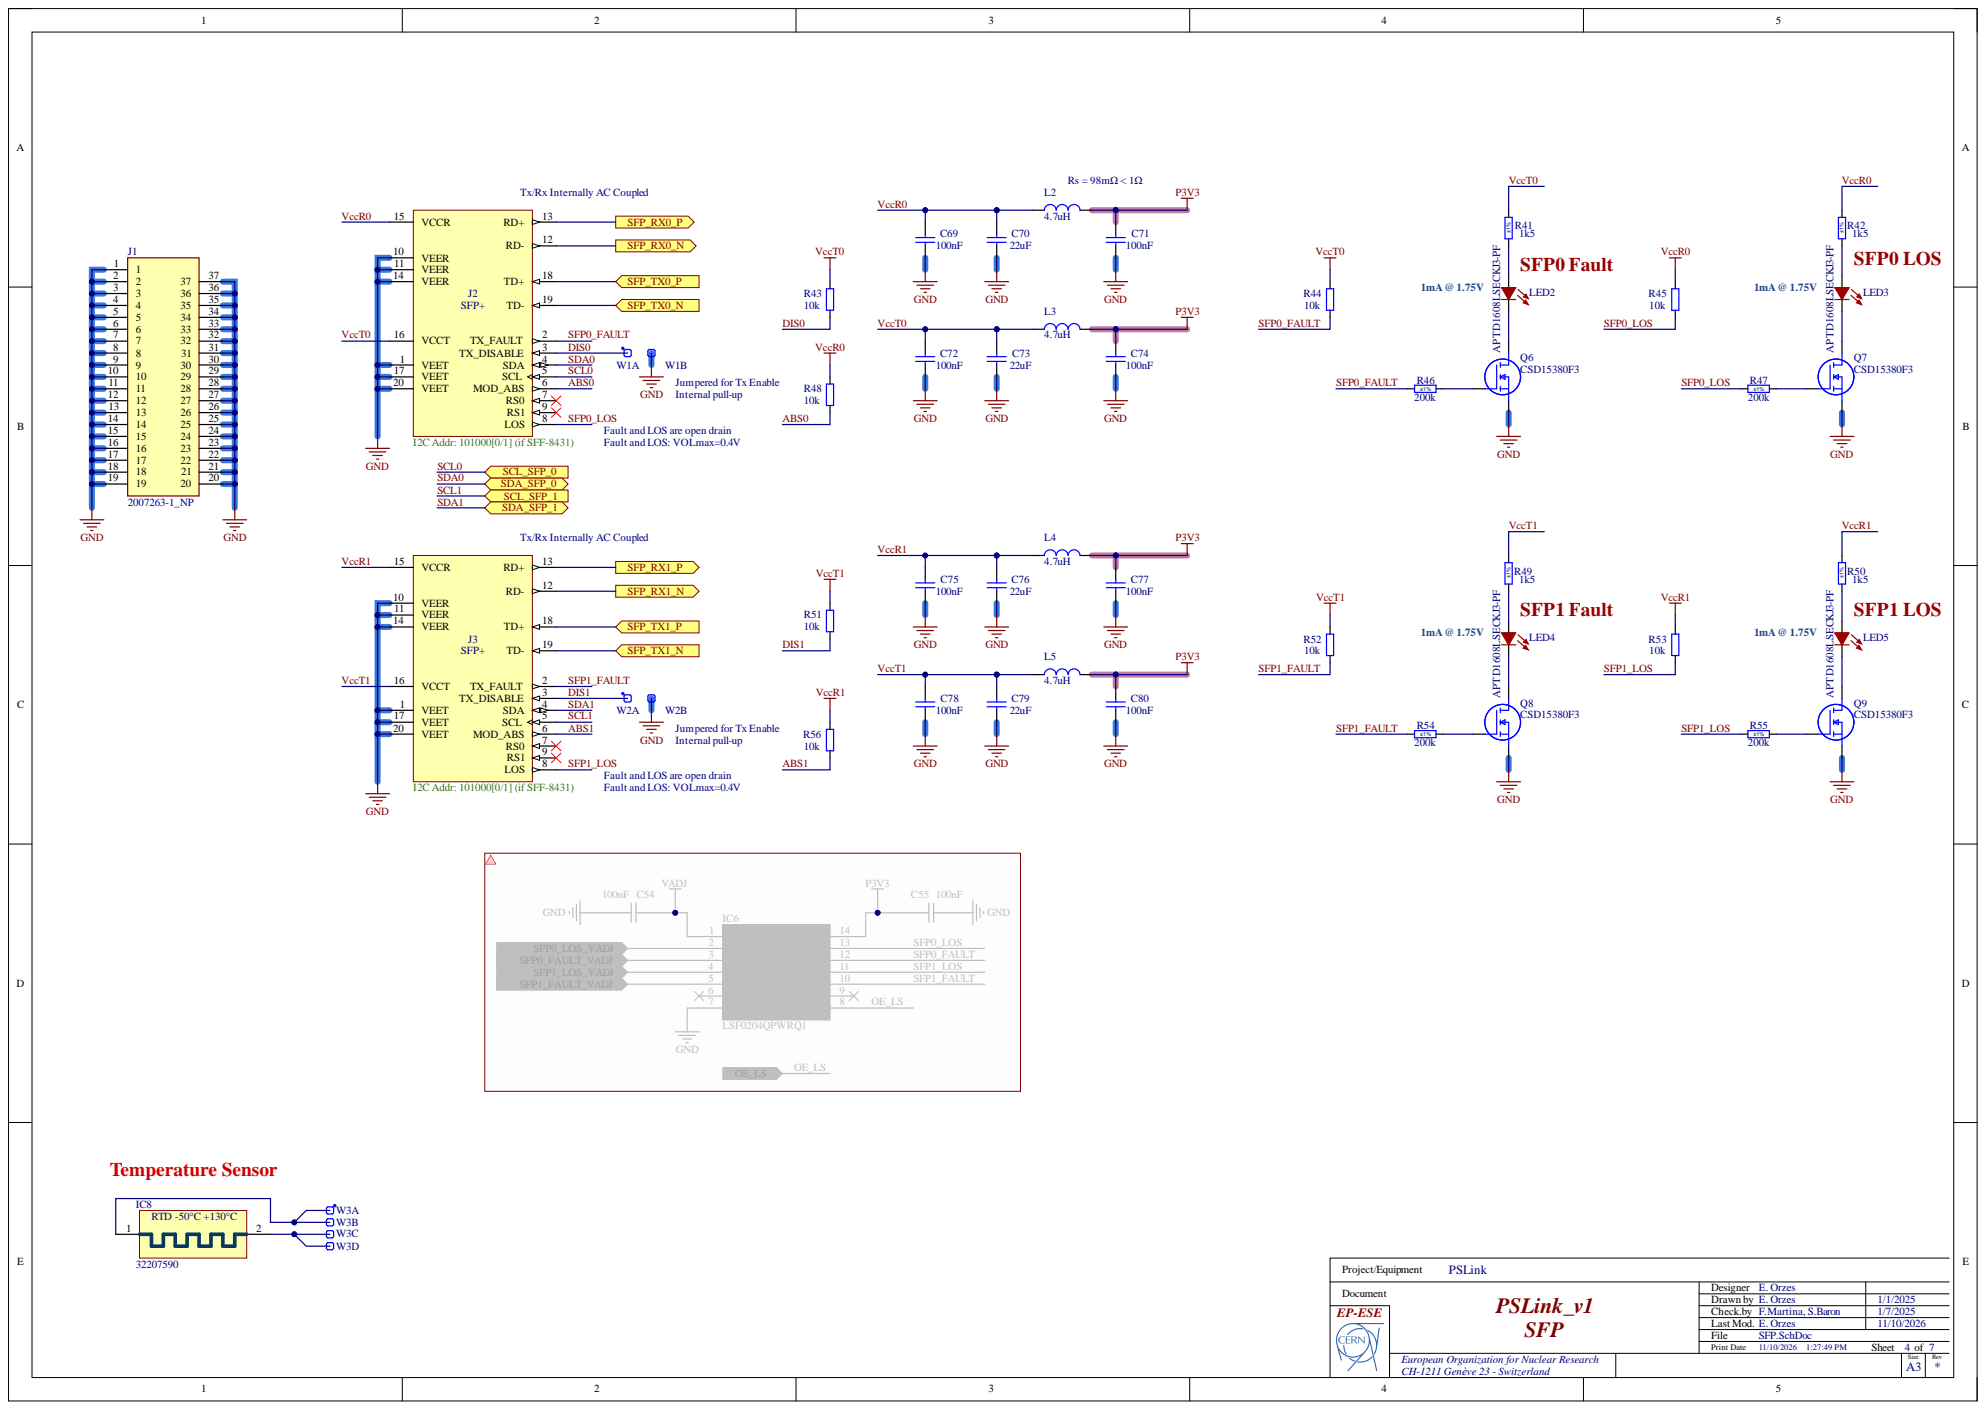
[picture p13: page 7]

I2C Addr: 101000[0/1] (if SFF-8431)

mpered for Tx Enabl

Fault and LOS are open drain
Fault and LOS: VOLmax=0

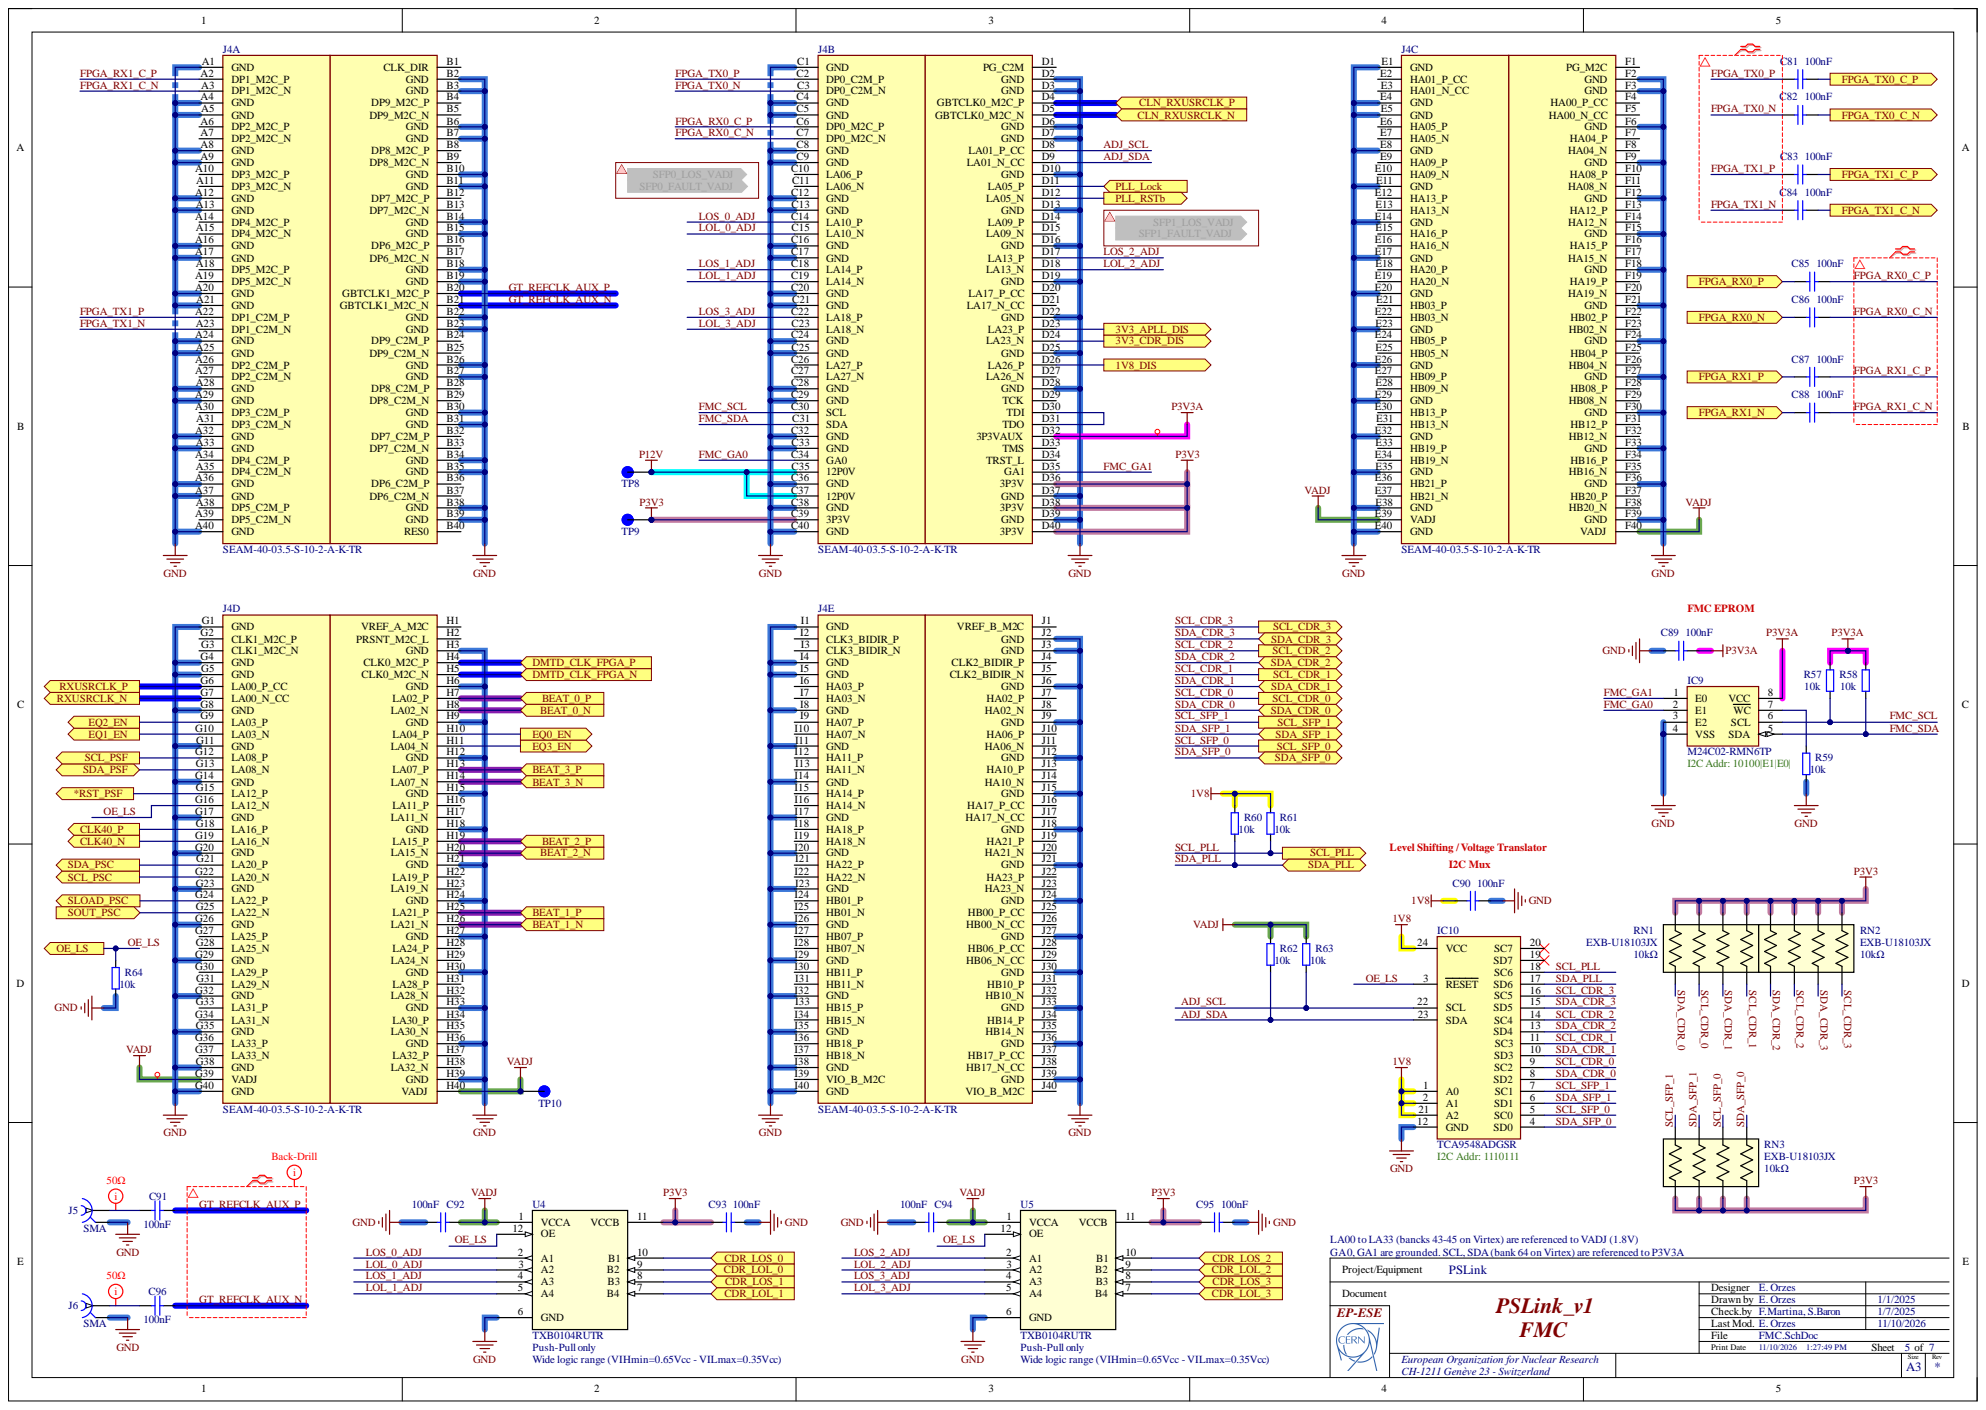
[picture p14: page 8]

Level Shifting / Voltage Translator

LA00 to LA33 (bancks 43-45 on Virtex) are referenced to VADJ (1.8V)
GA0, GA1 are grounded. SCL, SDA (bank 64 on Virtex) are referenced to P3V3A

Designer E. Orzes
Drawn by E. Orzes
Check.by F.Martina, S.Baron

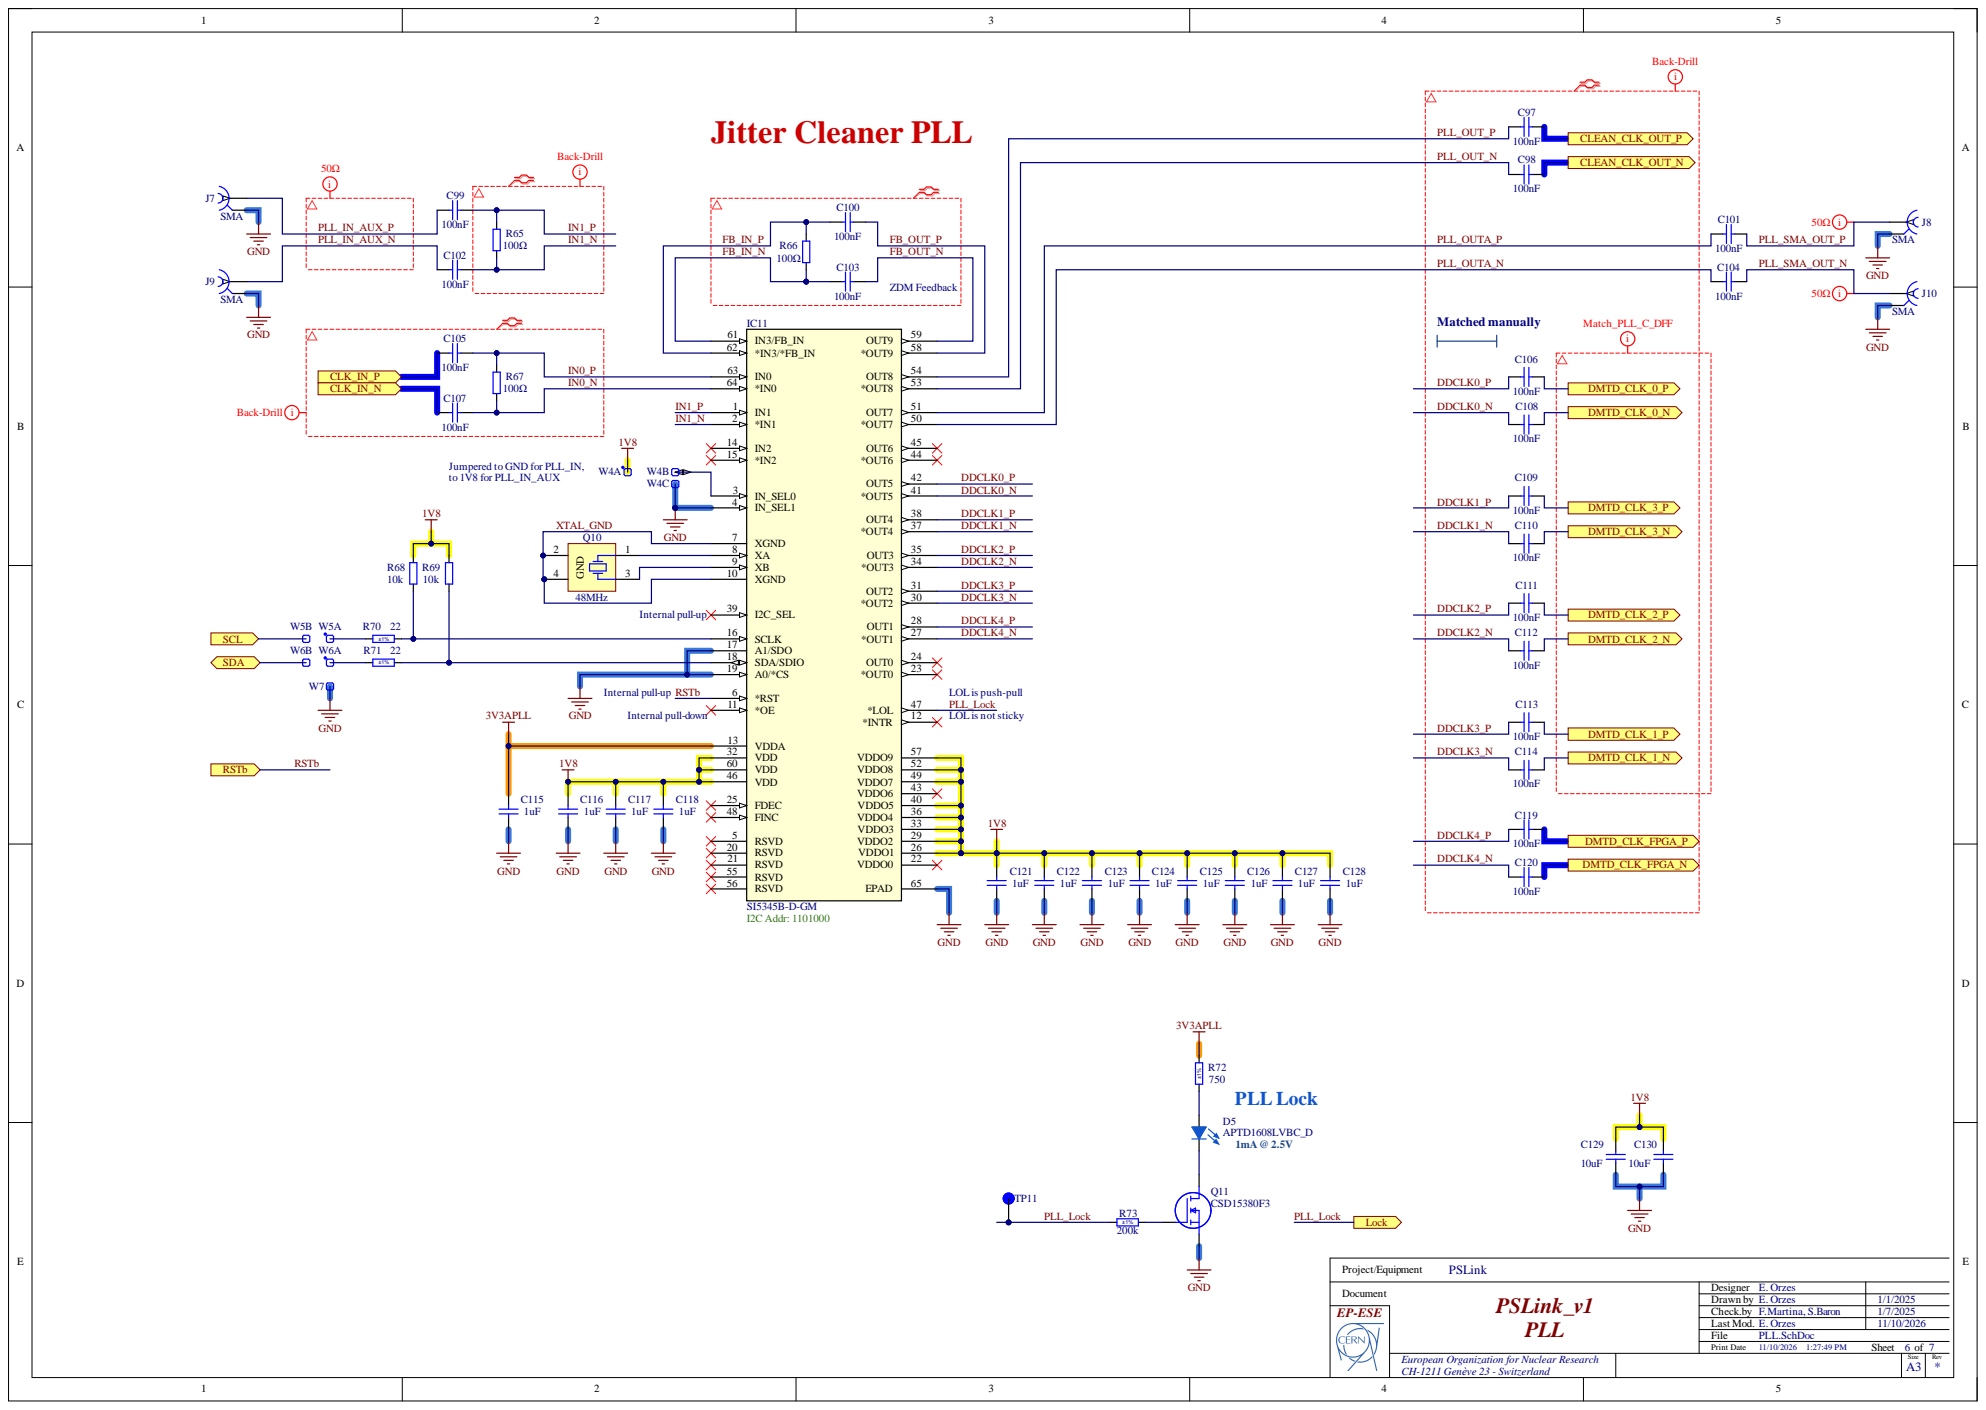
[picture p15: page 9]

IN0_N | *IN0 64 | | DDCLK0_P

IN1_P | | IN1 1 | DDCLK0_N

Jumpered to GND for PLL_IN,

A1/SDO 17
SDA/SDIO 18

Designer E. Orzes
Drawn by E. Orzes
Check.by F.Martina, S.Baron

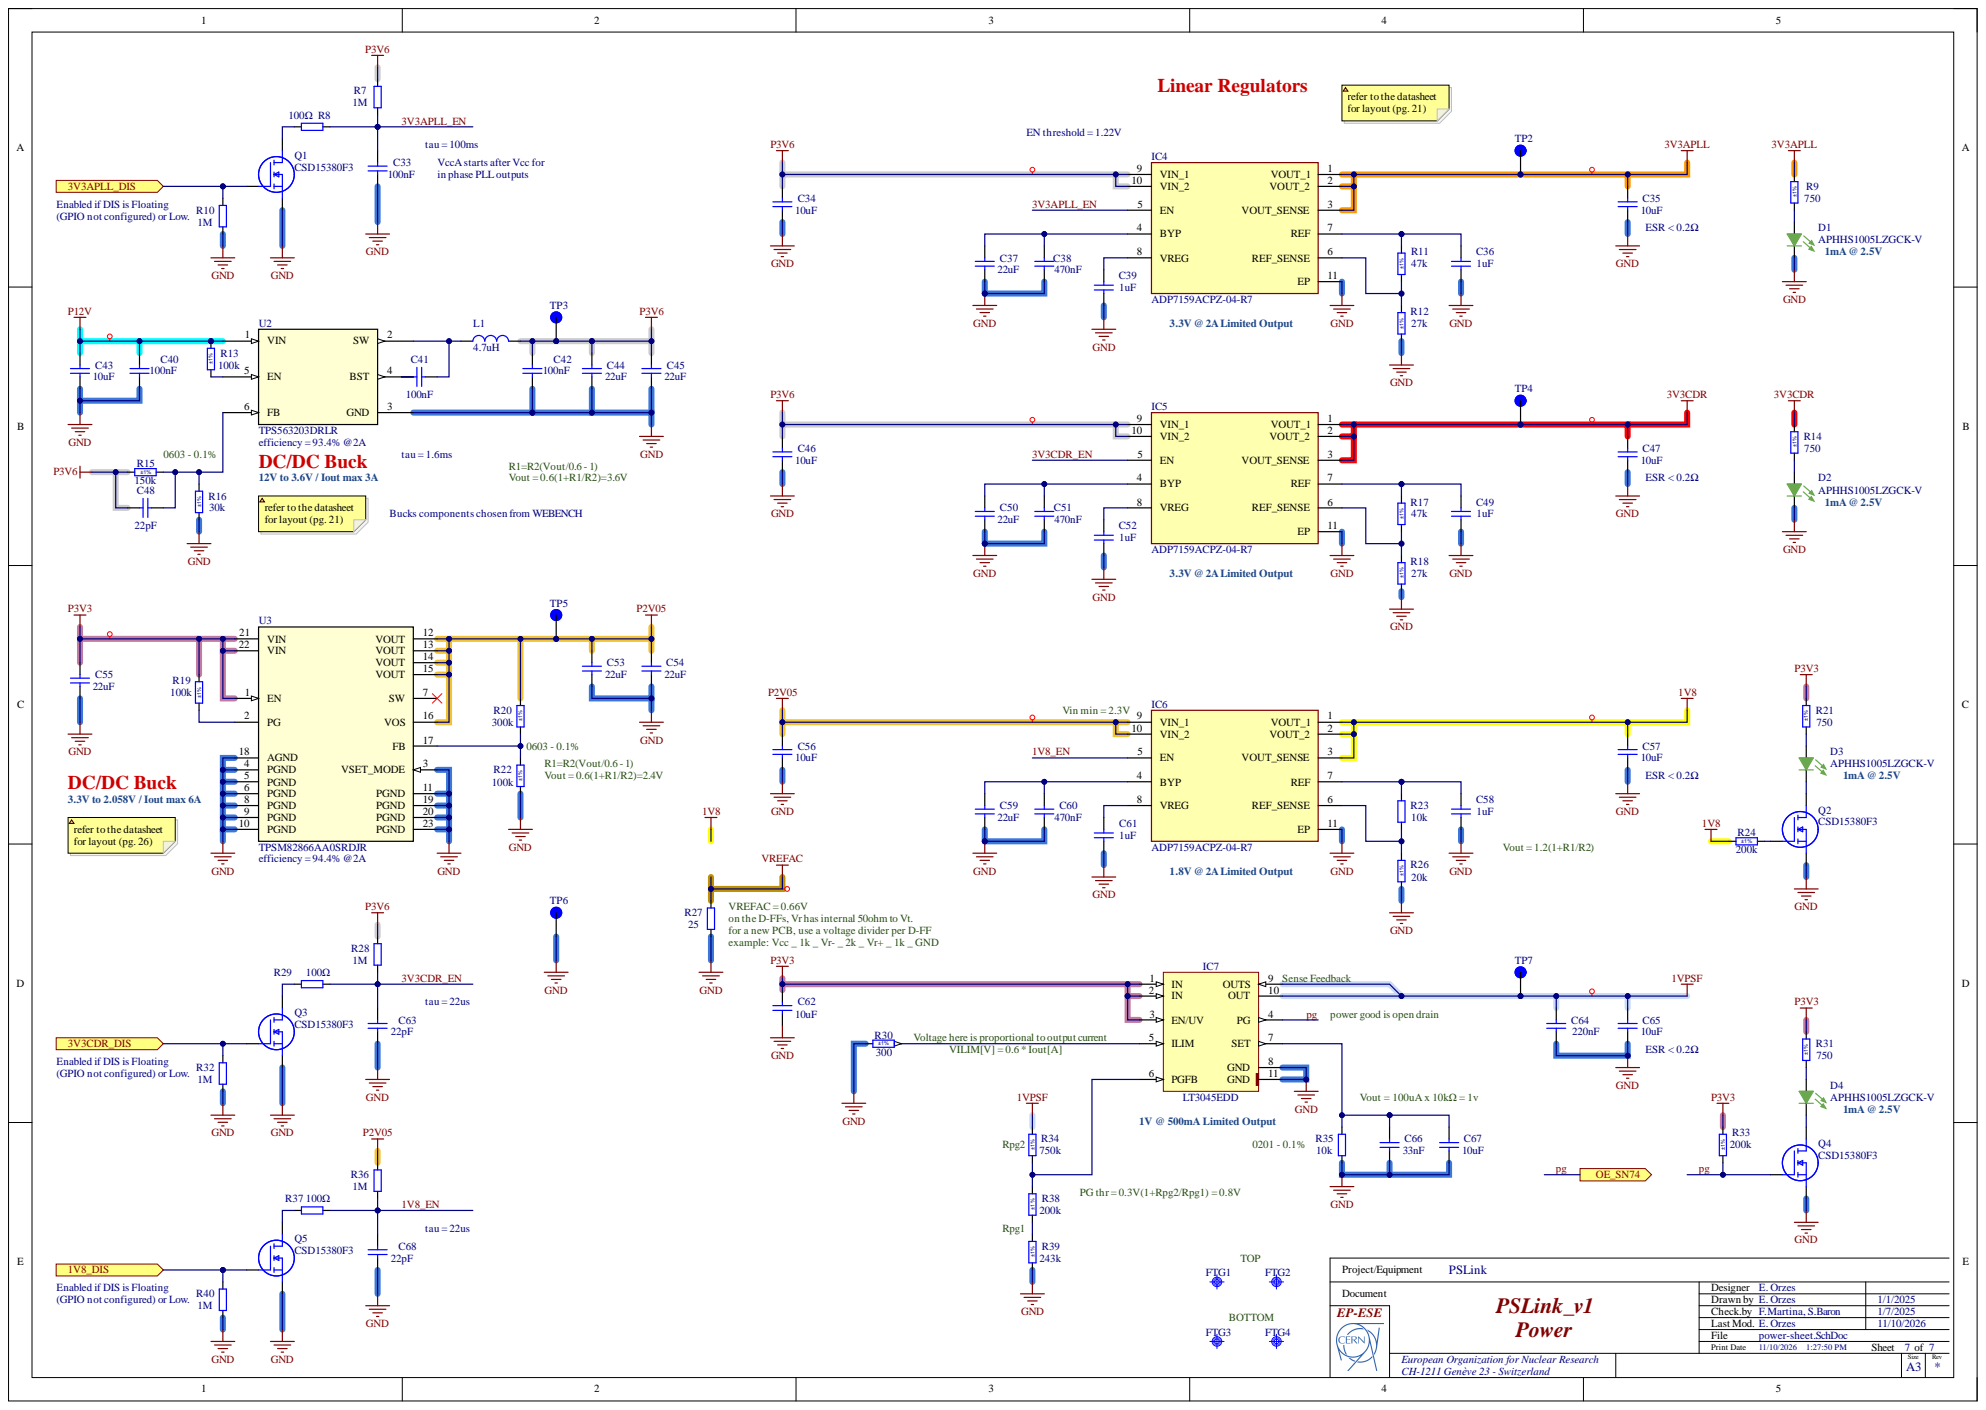
[picture p16: page 10]

tau = 100ms tau = 22us tau = 22us
VccA starts after Vcc for
in phase PLLou

3V3APLL_D
Enabled if DIS is Floating
(GPIO

not configured) or Lo

DC/DC Buck 3.3V to 2.058V / Iout max 6A

use a voltage divider per D-FF

power good is open drain

3V3CDR_DI

8 | Vou D
1 1
