eorzes/PSLink_v1/bypass-12V.pdf

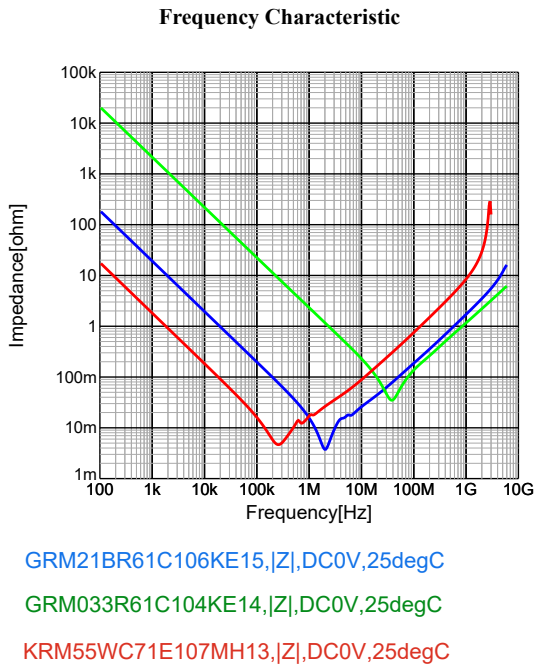
[picture p17: page 1]
Frequency Characteristic; Frequency[Hz]; Impedance[ohm]; GRM21BR61C106KE15,|Z|,DC0V,25degC GRM033R61C104KE14,|Z|,DC0V,25degC; KRM55WC71E107MH13,|Z|,DC0V,25degC
