eorzes/PSLink_v1/Netlists/Draft1.asc

I1: current
M1: nmos
M2: nmos
R1: res
R2: res
V1: voltage
V2: voltage
V3: voltage
Named nets: 0, M1_IN, M2_IN
