eorzes/PSLink_v1/SI_simulations/CML_Driver/Draft1.asc

C1: cap; 22µ
C2: cap; 22µ
I1: current; 16m
Q1: npn
Q2: npn
R1: res; 50
R2: res; 50
R3: res; 50
R4: res; 50
V1: voltage; 1.8
V2: voltage; PULSE(0 0.5 0 0 0 1n 2n 100)
V3: voltage; PULSE(0 0.5 1n 0 0 1n 2n 100)
Named nets: 0, IN_P, IN_N, OUT_P, OUT_N, Vdd, OUT_C_P, OUT_C_N
.tran 0 100n 0 10p
