eorzes/PSLink_v1/(list of files, drawings)

Other design files:
base_transition.PcbDoc
FMC.SchDoc
lane.SchDoc
P-CAD-ASCII.PCB
P-CAD.PCB
PCB.PcbDoc
phase-shifters.SchDoc
PLL.SchDoc
power-routing.PcbDoc
power-sheet.SchDoc
PSLink_v1.PrjPcb
SFP.SchDoc
top.SchDoc
top.SchLib
