eorzes/PSLink_v1/(commit log)

2025-04-04 new buck
    [Channel.SchDoc, FMC.SchDoc, PLL.SchDoc, PSLink_v1.PrjPcb, SFP.SchDoc, power-sheet.SchDoc, top.SchDoc]
2025-04-07 vias and poly update
    [SFP.SchDoc]
2025-04-08 poly opt
    [FMC.SchDoc, PLL.SchDoc, PSLink_v1.PrjPcb, power-sheet.SchDoc]
2025-04-10 voltage divider fix
    [Channel.SchDoc, PSLink_v1.PrjPcb, power-sheet.SchDoc]
2025-04-15 annotation reset
    [Channel.SchDoc, FMC.SchDoc, PLL.SchDoc, SFP.SchDoc, phase-shifters.SchDoc, power-sheet.SchDoc, top.SchDoc]
2025-04-15 channel renamed to lane
    [Channel.SchDoc, PSLink_v1.PrjPcb, lane.SchDoc, top.SchDoc]
2025-04-16 signature & silkscreen
    [PLL.SchDoc, PSLink_v1.PrjPcb, SFP.SchDoc, power-sheet.SchDoc]
2025-04-28 added testpoints
    [FMC.SchDoc, phase-shifters.SchDoc]
